vekkax/Braille_Display/Circuit_design/imports/Same_Sky_CMT-8503-90-SMT-TR/BOM.txt

3DX_Same_Sky_Supplier: Same Sky
3DX_Same_Sky_Description: 8.5 mm, 3.6 Vo-p, 90 dB, Surface Mount (SMT), Magnetic Audio Transducer Buzzer
3DX_Same_Sky_Model Number: CMT-8503-90-SMT-TR
