vekkax/Braille_Display/3d_models/Print_files/[24 piezas] cam.stl

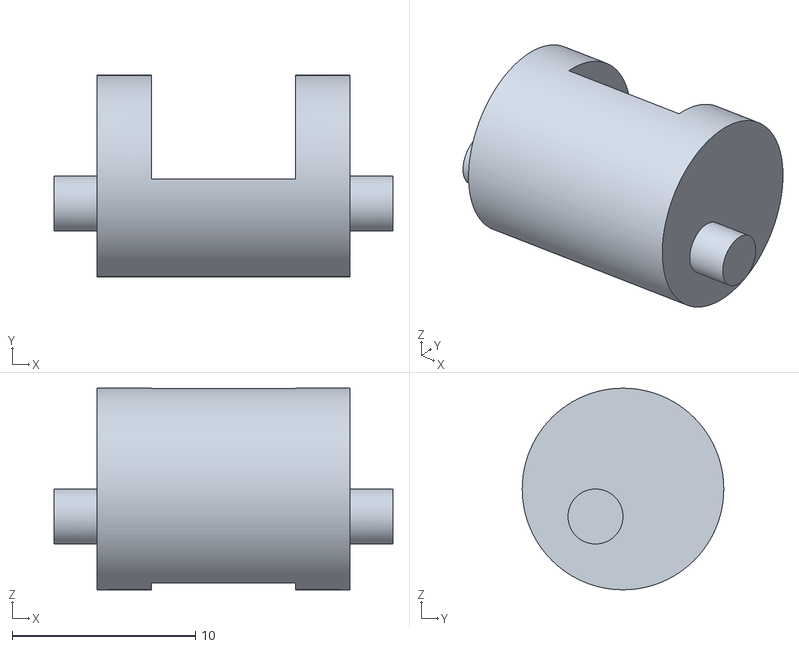
[picture p1: CAD file, 2025-09-04]
3d_models/Print_files/[24 piezas] cam.stl
18.5 x 11.0 x 11.0
