vekkax/Braille_Display/Circuit_design/cuts.dxf

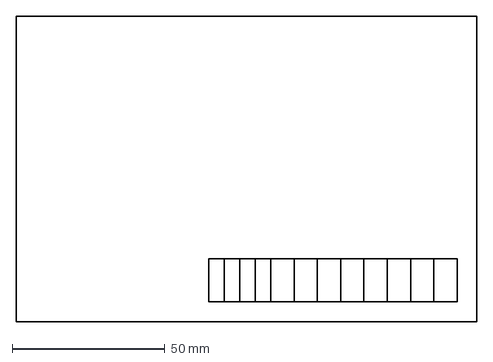
[picture p2: CAD file, 2025-09-04]
Circuit_design/cuts.dxf
150.5 x 100.0 mm
