vekkax/Braille_Display/Circuit_design/imports/AP7583AQ-33MP-13/3D/AP7583AQ-33MP-13.stp

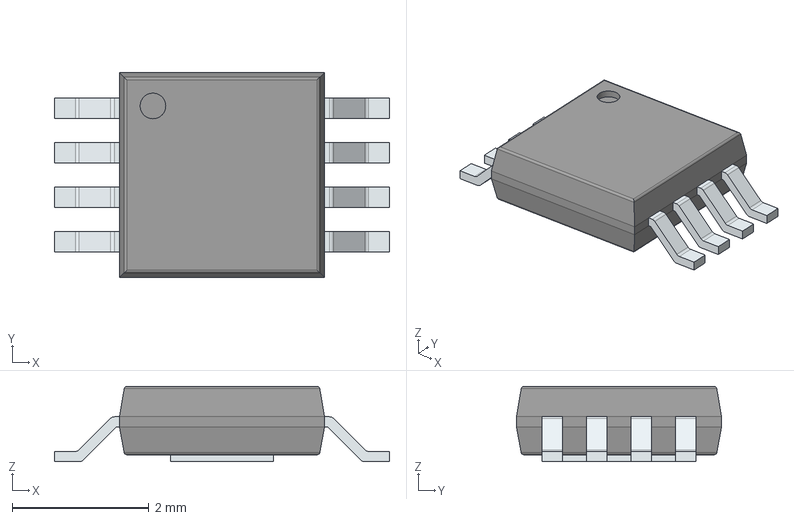
[picture p3: CAD file, 2025-09-04]
Circuit_design/imports/AP7583AQ-33MP-13/3D/AP7583AQ-33MP-13.stp
4.90 x 3.00 x 1.10 mm
PinsArrayLR
ThermalPad
