vekkax/Braille_Display/Circuit_design/imports/CMT-0525-75-SMT-TR/CMT-0525-75-SMT-TR.step

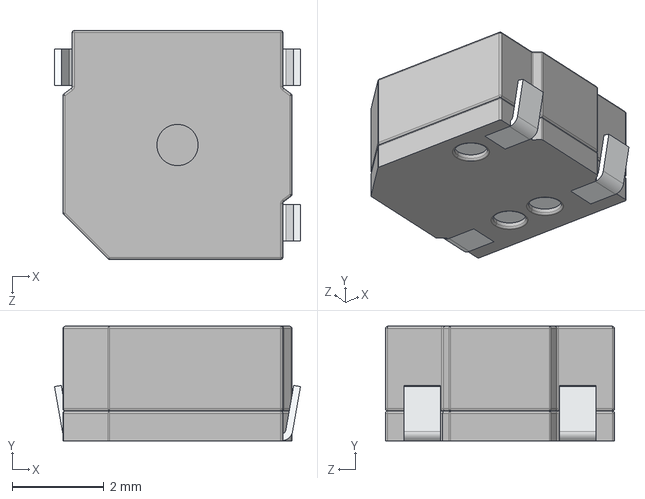
[picture p4: CAD file, 2025-09-04]
Circuit_design/imports/CMT-0525-75-SMT-TR/CMT-0525-75-SMT-TR.step
5.37 x 2.50 x 5.00 mm
