vekkax/Braille_Display/Circuit_design/imports/CMT-8503-90-SMT-TR/CMT-8503-90-SMT-TR.step

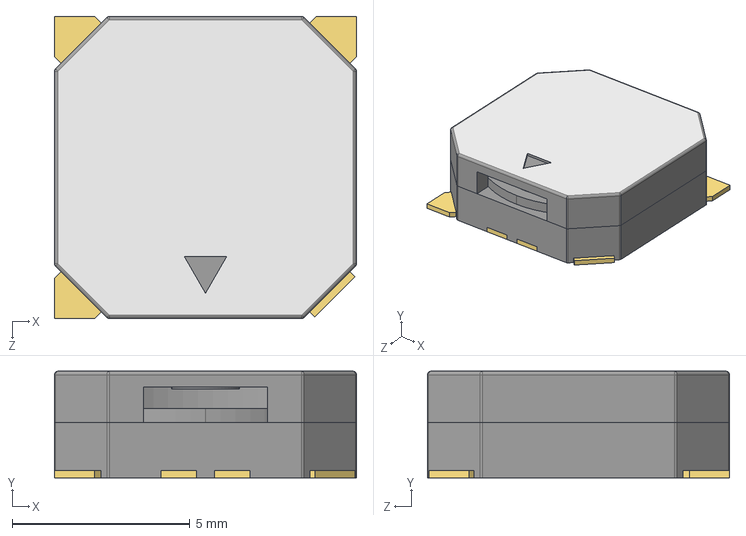
[picture p5: CAD file, 2025-09-04]
Circuit_design/imports/CMT-8503-90-SMT-TR/CMT-8503-90-SMT-TR.step
8.50 x 3.00 x 8.50 mm
