vekkax/Braille_Display/Circuit_design/imports/IHLP2525CZER4R7MA1/IHLP2525CZ.step

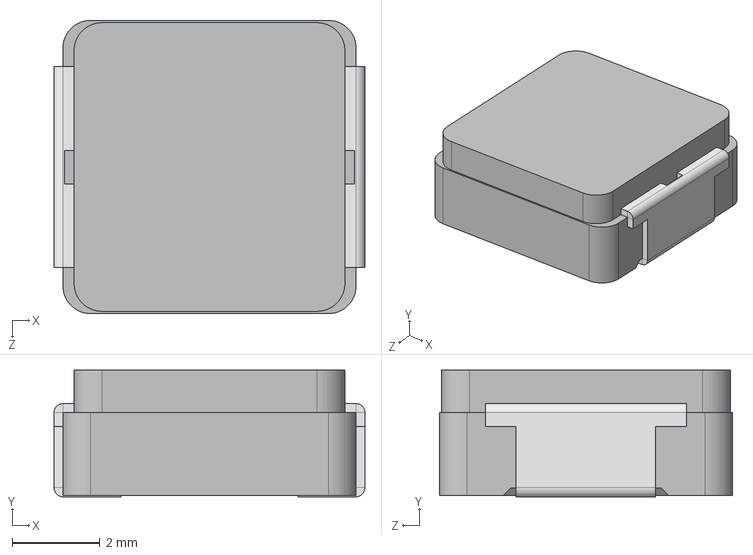
[picture p6: CAD file, 2025-09-04]
Circuit_design/imports/IHLP2525CZER4R7MA1/IHLP2525CZ.step
7.08 x 2.88 x 6.67 mm
