vekkax/Braille_Display/Circuit_design/imports/STM32F031G4U6.step

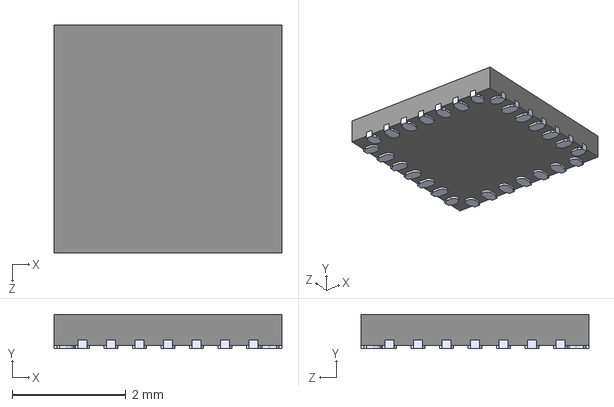
[picture p7: CAD file, 2025-09-04]
Circuit_design/imports/STM32F031G4U6.step
4.00 x 0.6 x 4.00 mm
