vekkax/Braille_Display/Circuit_design/Panelization/Top_layer.step

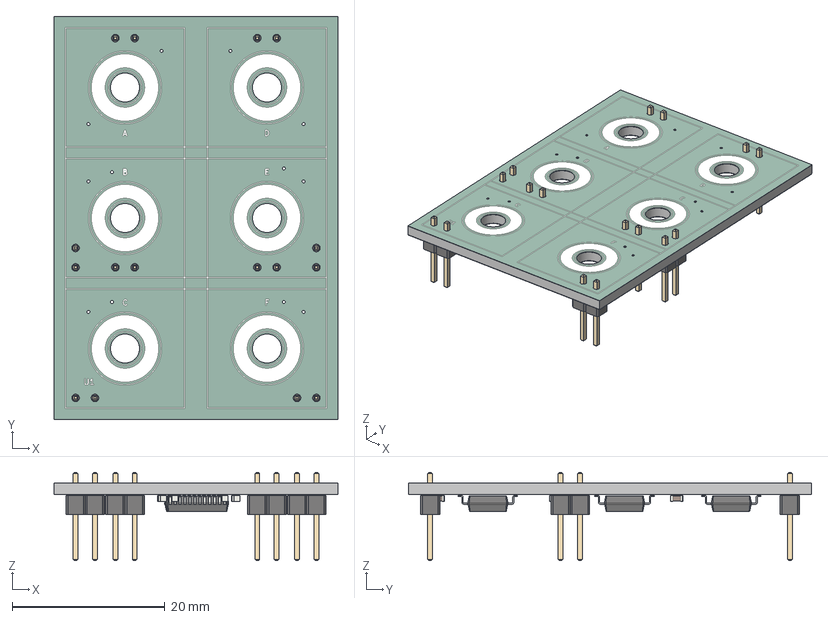
[picture p8: CAD file, 2025-09-04]
Circuit_design/Panelization/Top_layer.step
37.2 x 52.8 x 11.5 mm
PinHeader_1x02_P2.54mm_Vertical x 8
C_0603_1608Metric x 12
SSOP-24_5.3x8.2mm_P0.65mm x 3
Top_layer_silkscreen
Top_layer_soldermask
Top_layer_PCB
