vekkax/Braille_Display/3d_models/Print_files/[24 piezas] dot.stl

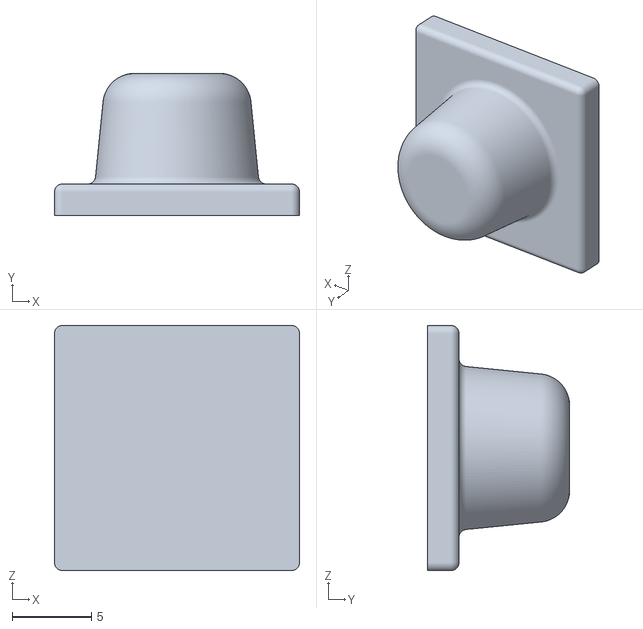
[picture p9: CAD file, 2025-09-04]
3d_models/Print_files/[24 piezas] dot.stl
15.5 x 9.00 x 15.5
