vekkax/Braille_Display/Circuit_design/imports/QFN18_2mmx3mm_model.step

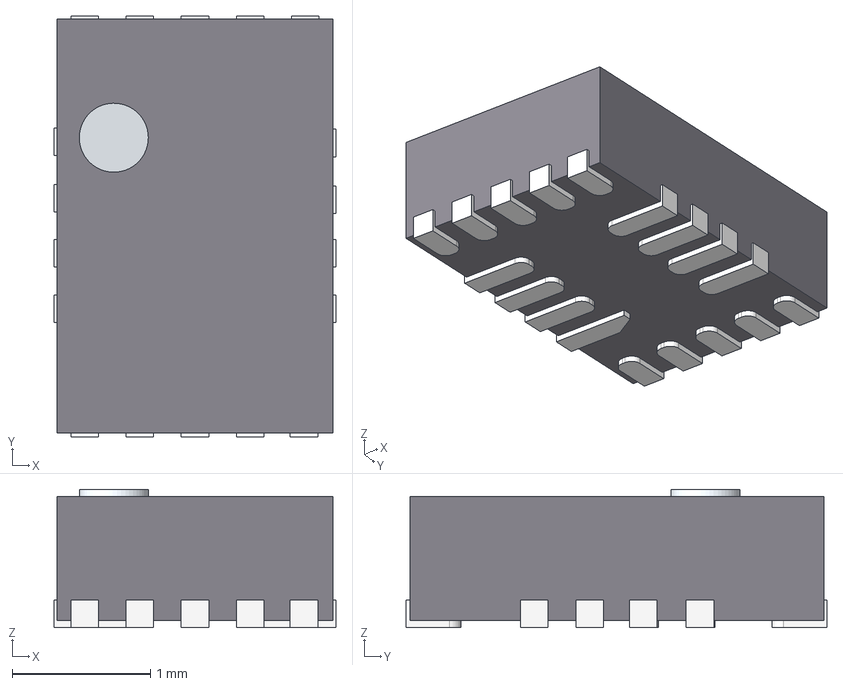
[picture p10: CAD file, 2025-09-04]
Circuit_design/imports/QFN18_2mmx3mm_model.step
2.04 x 3.05 x 1.00 mm
Pin1-IndexPad
Pin2-LongPad
Pin3-LongPad
Pin4-LongPad
Pin5-ShortPad
Pin6-ShortPad
Pin7-ShortPad
Pin8-ShortPad
Pin9-ShortPad
Pin10-LongPad
Pin11-LongPad
Pin12-LongPad
Pin13-LongPad
Pin14-ShortPad
Pin15-ShortPad
Pin16-ShortPad
Pin17-ShortPad
Pin18-ShortPad
CopyPart__Feature
