vekkax/Braille_Display/Circuit_design/imports/STM32L031F6P6.step

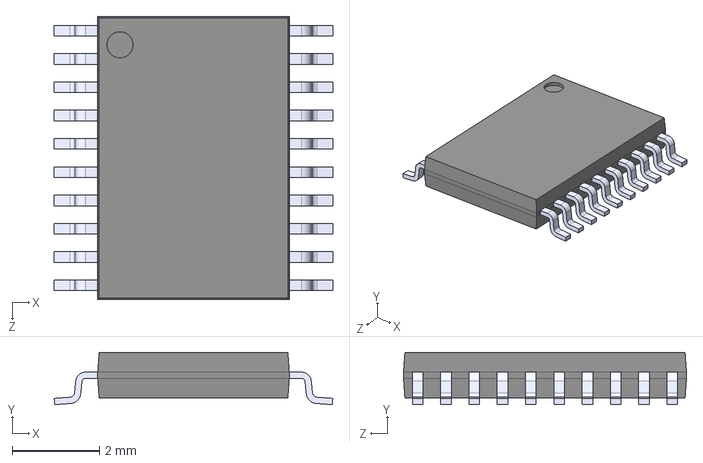
[picture p12: CAD file, 2025-09-04]
Circuit_design/imports/STM32L031F6P6.step
6.40 x 1.20 x 6.50 mm
