vekkax/Braille_Display/3d_models/Print_files/[4 piezas] inner_top.stl

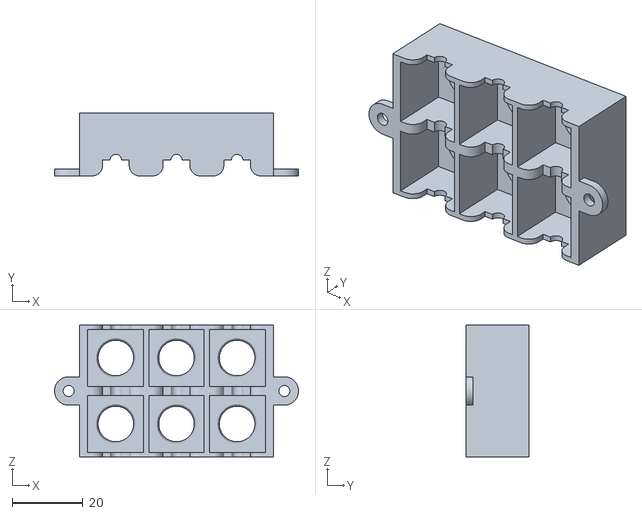
[picture p13: CAD file, 2025-09-04]
3d_models/Print_files/[4 piezas] inner_top.stl
68.8 x 17.8 x 37.2
