vekkax/Braille_Display/Circuit_design/imports/TB6612FNG.step

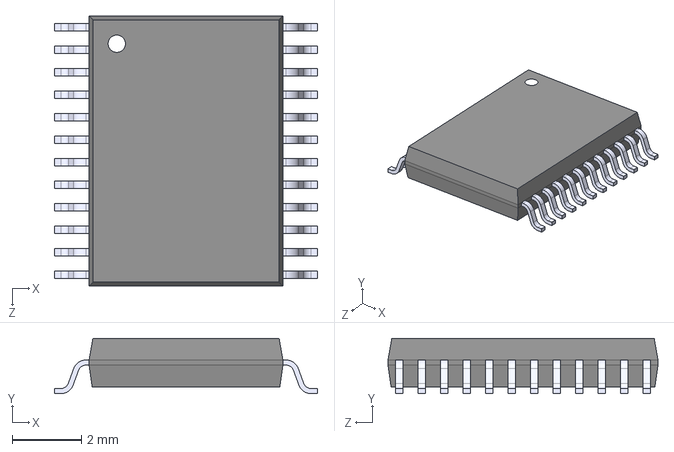
[picture p14: CAD file, 2025-09-04]
Circuit_design/imports/TB6612FNG.step
7.60 x 1.60 x 7.80 mm
