vekkax/Braille_Display/3d_models/Print_files/[4 piezas] inner_conn.stl

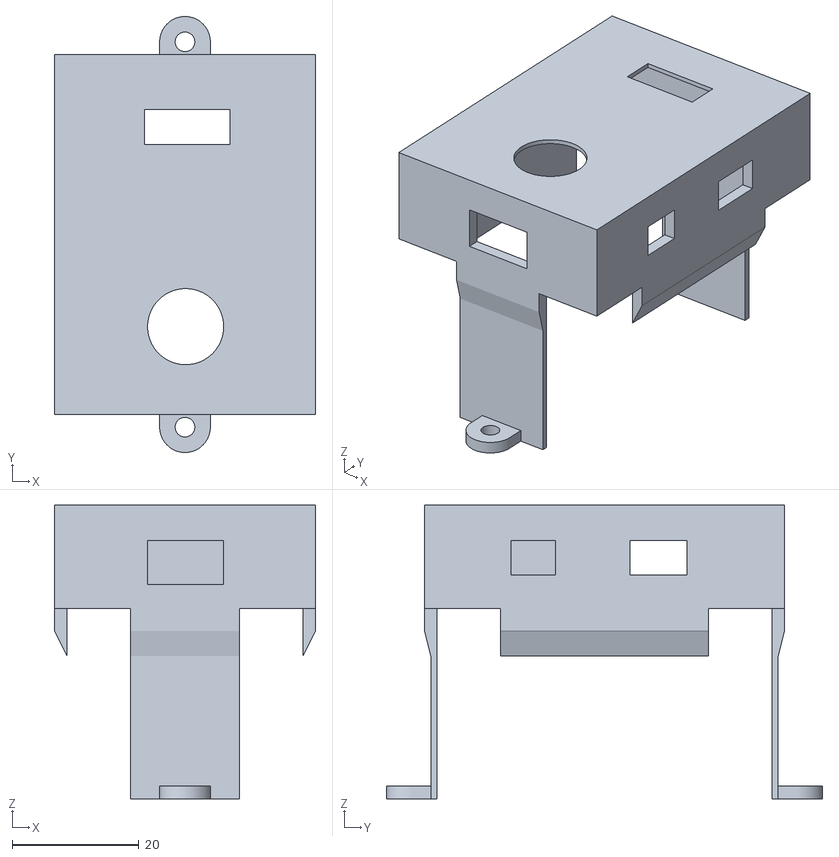
[picture p15: CAD file, 2025-09-04]
3d_models/Print_files/[4 piezas] inner_conn.stl
41.2 x 68.8 x 46.3
