vekkax/Braille_Display/3d_models/Print_files/[4 piezas] shell_top.stl

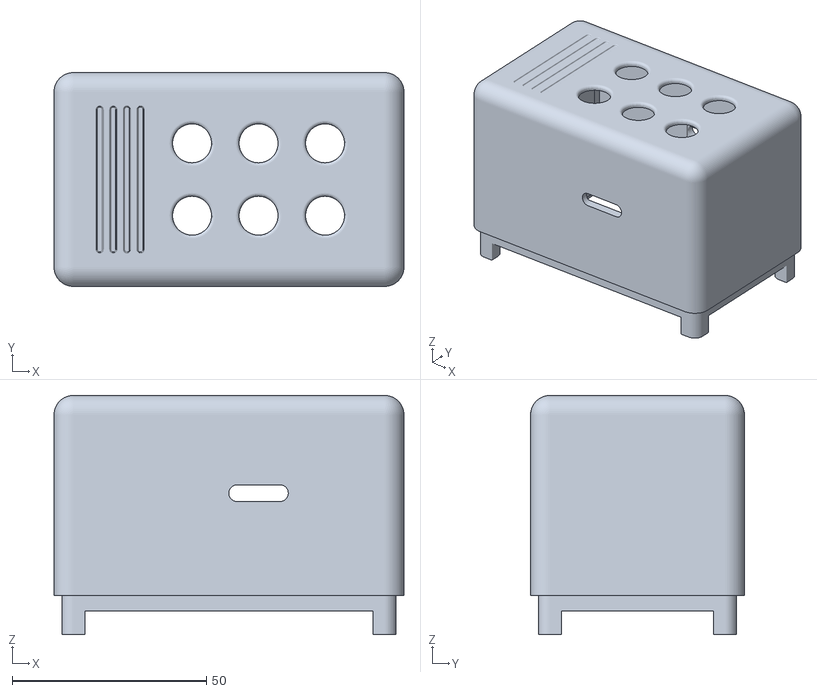
[picture p16: CAD file, 2025-09-04]
3d_models/Print_files/[4 piezas] shell_top.stl
90.0 x 55.0 x 61.5
