vekkax/Braille_Display/3d_models/Print_files/[4 piezas] inner_bttm.stl

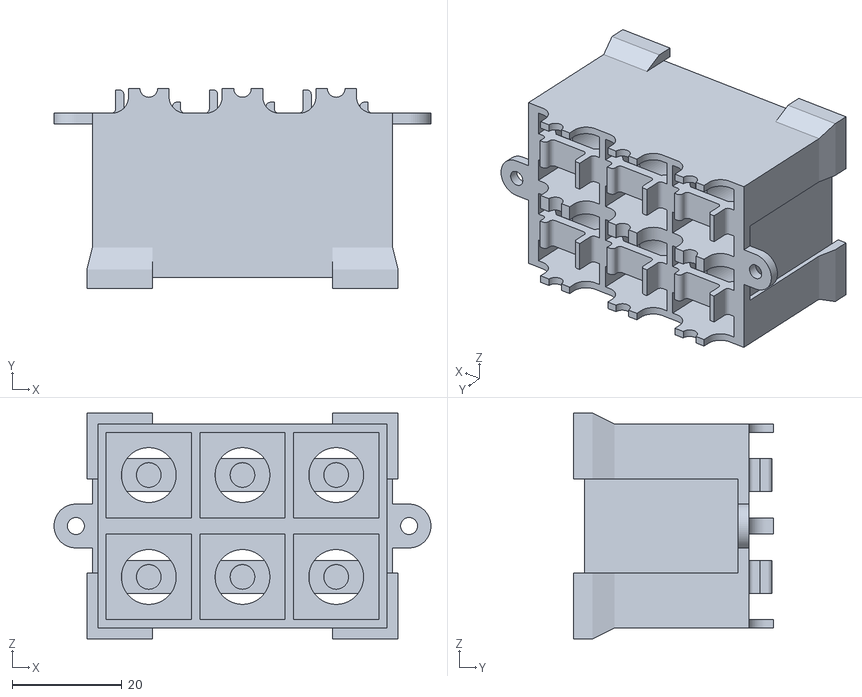
[picture p17: CAD file, 2025-09-04]
3d_models/Print_files/[4 piezas] inner_bttm.stl
68.8 x 36.5 x 41.2
