vekkax/Braille_Display/(list of files, cad)

Other CAD files:
Circuit_design/imports/Same_Sky_CMT-8503-90-SMT-TR/Same_Sky_CMT-8503-90-SMT-TR.step
Circuit_design/Circuit_design-B_Paste.dxf
Circuit_design/Panelization/Bottom_layer-F_Mask.dxf
Circuit_design/Panelization/Bottom_layer-F_Paste.dxf
Circuit_design/Panelization/Bottom_layer/Bottom_layer/AP7583AQ-33MP-13.iam
Circuit_design/Panelization/Bottom_layer/Bottom_layer/Body.ipt
Circuit_design/Panelization/Bottom_layer/Bottom_layer/Body_1.ipt
Circuit_design/Panelization/Bottom_layer/Bottom_layer/Bottom_layer.iam
Circuit_design/Panelization/Bottom_layer/Bottom_layer/Bottom_layer_PCB.ipt
Circuit_design/Panelization/Bottom_layer/Bottom_layer/Bottom_layer_silkscreen.ipt
Circuit_design/Panelization/Bottom_layer/Bottom_layer/Bottom_layer_soldermask.ipt
Circuit_design/Panelization/Bottom_layer/Bottom_layer/Box.ipt
Circuit_design/Panelization/Bottom_layer/Bottom_layer/C_0603_1608Metric.ipt
Circuit_design/Panelization/Bottom_layer/Bottom_layer/C_0805_2012Metric.ipt
Circuit_design/Panelization/Bottom_layer/Bottom_layer/CopyPart__Feature.ipt
Circuit_design/Panelization/Bottom_layer/Bottom_layer/D_SOD-923.ipt
Circuit_design/Panelization/Bottom_layer/Bottom_layer/IHLP2525CZ.ipt
Circuit_design/Panelization/Bottom_layer/Bottom_layer/JST_PH_S2B-PH-K_1x02_P2.00mm_Horizontal.ipt
Circuit_design/Panelization/Bottom_layer/Bottom_layer/JST_PH_S3B-PH-K_1x03_P2.00mm_Horizontal.ipt
Circuit_design/Panelization/Bottom_layer/Bottom_layer/Pad.ipt
Circuit_design/Panelization/Bottom_layer/Bottom_layer/Pin1-IndexPad.ipt
Circuit_design/Panelization/Bottom_layer/Bottom_layer/Pin10-LongPad.ipt
Circuit_design/Panelization/Bottom_layer/Bottom_layer/Pin11-LongPad.ipt
Circuit_design/Panelization/Bottom_layer/Bottom_layer/Pin12-LongPad.ipt
Circuit_design/Panelization/Bottom_layer/Bottom_layer/Pin13-LongPad.ipt
Circuit_design/Panelization/Bottom_layer/Bottom_layer/Pin14-ShortPad.ipt
Circuit_design/Panelization/Bottom_layer/Bottom_layer/Pin15-ShortPad.ipt
Circuit_design/Panelization/Bottom_layer/Bottom_layer/Pin16-ShortPad.ipt
Circuit_design/Panelization/Bottom_layer/Bottom_layer/Pin17-ShortPad.ipt
Circuit_design/Panelization/Bottom_layer/Bottom_layer/Pin18-ShortPad.ipt
Circuit_design/Panelization/Bottom_layer/Bottom_layer/Pin2-LongPad.ipt
Circuit_design/Panelization/Bottom_layer/Bottom_layer/Pin3-LongPad.ipt
Circuit_design/Panelization/Bottom_layer/Bottom_layer/Pin4-LongPad.ipt
Circuit_design/Panelization/Bottom_layer/Bottom_layer/Pin5-ShortPad.ipt
Circuit_design/Panelization/Bottom_layer/Bottom_layer/Pin6-ShortPad.ipt
Circuit_design/Panelization/Bottom_layer/Bottom_layer/Pin7-ShortPad.ipt
Circuit_design/Panelization/Bottom_layer/Bottom_layer/Pin8-ShortPad.ipt
Circuit_design/Panelization/Bottom_layer/Bottom_layer/Pin9-ShortPad.ipt
Circuit_design/Panelization/Bottom_layer/Bottom_layer/PinHeader_2x05_P1.27mm_Vertical.ipt
Circuit_design/Panelization/Bottom_layer/Bottom_layer/PinSocket_1x02_P2.54mm_Vertical.ipt
Circuit_design/Panelization/Bottom_layer/Bottom_layer/PinsArrayLR.ipt
Circuit_design/Panelization/Bottom_layer/Bottom_layer/QFN18_2mmx3mm_model.iam
Circuit_design/Panelization/Bottom_layer/Bottom_layer/R_0805_2012Metric.ipt
Circuit_design/Panelization/Bottom_layer/Bottom_layer/STM32F031G4U6.ipt
Circuit_design/Panelization/Bottom_layer/Bottom_layer/ThermalPad.ipt
Circuit_design/Panelization/Top_layer/Top_layer/C_0603_1608Metric.ipt
Circuit_design/Panelization/Top_layer/Top_layer/PinHeader_1x02_P2.54mm_Vertical.ipt
Circuit_design/Panelization/Top_layer/Top_layer/SSOP-24_5.3x8.2mm_P0.65mm.ipt
Circuit_design/Panelization/Top_layer/Top_layer/Top_layer.iam
Circuit_design/Panelization/Top_layer/Top_layer/Top_layer_PCB.ipt
Circuit_design/Panelization/Top_layer/Top_layer/Top_layer_silkscreen.ipt
Circuit_design/Panelization/Top_layer/Top_layer/Top_layer_soldermask.ipt
Circuit_design/conector cuts.ipt
