vekkax/Braille_Display/Circuit_design/imports/EB_manual_en_20180921/GerberList.xls

GERBER LIST
■General information
Garber format |  | RS-274X
CAD |  | PADS
Layer |  | 4L
size |  | X: 180mm Y: 80mm
■Drill Data
 | Details | File name
1 | Drill data | DRILL
2 | Drill List | DRILL.TXT
■Gerber list
 | Details | File name
1 | 部品面パターン（Component side Pattern） | GTL
2 | 半田面パターン（Solder side Pattern） | GBL
3 | 部品面レジスト（Component side Resist） | GTS
4 | 半田面レジスト（Solder side Resist） | GBS
5 | 部品面シルク（Component side Silk） | GTO
6 | 半田面シルク（Solder side Silk） | -
7 | 外形（Board data） | OUTLINE
8 | 2層目のパターン（Ｌ2Pattern） | L2
9 | 3層目のパターン（Ｌ3Pattern） | L3
10 | 外形寸法図(Outline drawing) | sunpou.pdf
11 | 穴図（キリ穴有る場合に必要）(Hole drawing) | NTH drill drawing.pdf
12 | 部品面メタルマスク（Component side Paste） | GTP
13 | 半田面メタルマスク（Solder side Paste） | -
14 | 部品座標(Component coordinate data) | PARTS_xy.xls
15 | Vcut | -
16
17
18
19
20
Note: | 外形図以外のパターン図に外形レイヤーを含まない
 |  | 絶対座標(Absolute)
 |  | 相対座標(Increment)
 |  | ミリ(mm)
 |  | インチ(Inch)
 |  | リーディング(Leading)
 |  | トレイリング(Trailing)
 |  | サプレス無し(None)
 | 外形図に寸法・穴を記載しない
 | 内層反転の場合、外形よけベタ輪郭必要
■NC output option
座標系 | 絶対座標／相対座標 | 絶対座標(Absolute)
Coordinates | Absolute/Increment
単位 | ミリ／インチ | ミリ(mm)
Units | mm/Inch
ゼロ・サプレス | リーディング（先行）/トレイリング（後方）/無し | リーディング(Leading)
Zero supless | leading／trailing／none
小数点 | 整数部桁数：小数部桁数 (例）3 : 2 | 3:3
Digits | Integer : Decimal (ex.) 3 : 2
Note: | ＮＣ原点はガーバー原点と合致させる
 | インチ・ミリ系が混在していないこと
■Gerber output option (RS-274D only)
座標系 | 絶対座標／相対座標
Coordinates | Absolute/Increment
単位 | ミリ／インチ
Units | mm/Inch
ゼロ・サプレス | リーディング（先行）/トレイリング（後方）/無し
Zero supless | leading／trailing／none
小数点 | 整数部桁数：小数部桁数 (例）3 : 2
Digits | Integer : Decimal (ex.) 3 : 2
