vekkax/Braille_Display/Circuit_design/imports/EB_manual_en_20180921/drill drawing.pdf

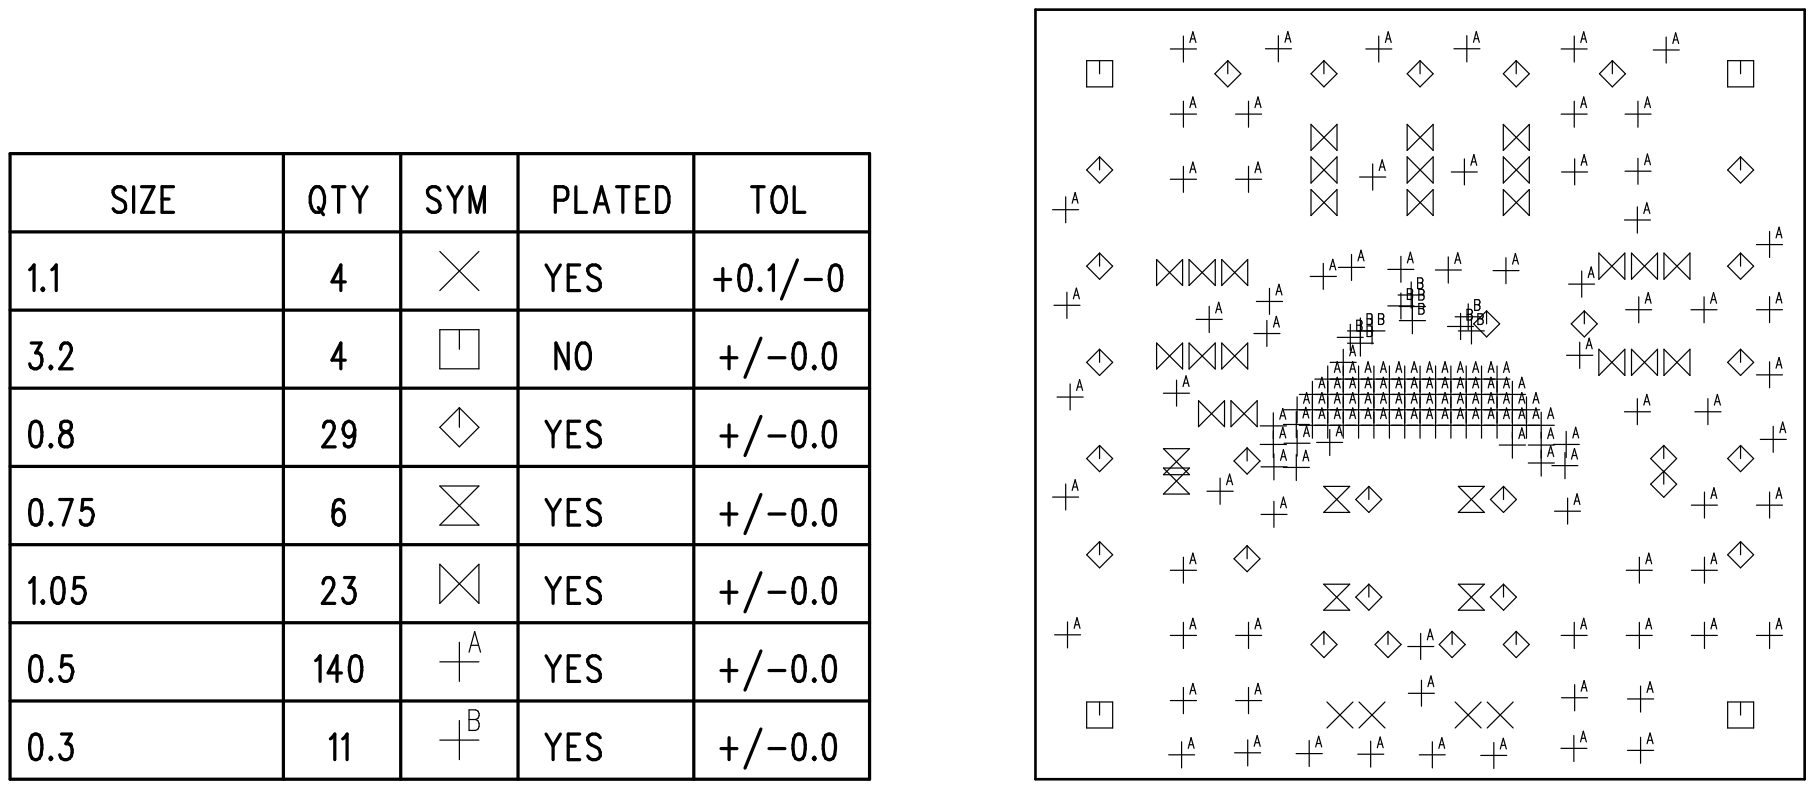
[picture p18: page 1]
