vekkax/Braille_Display/Circuit_design/imports/EB_manual_en_20180921/NTH drill drawing.pdf

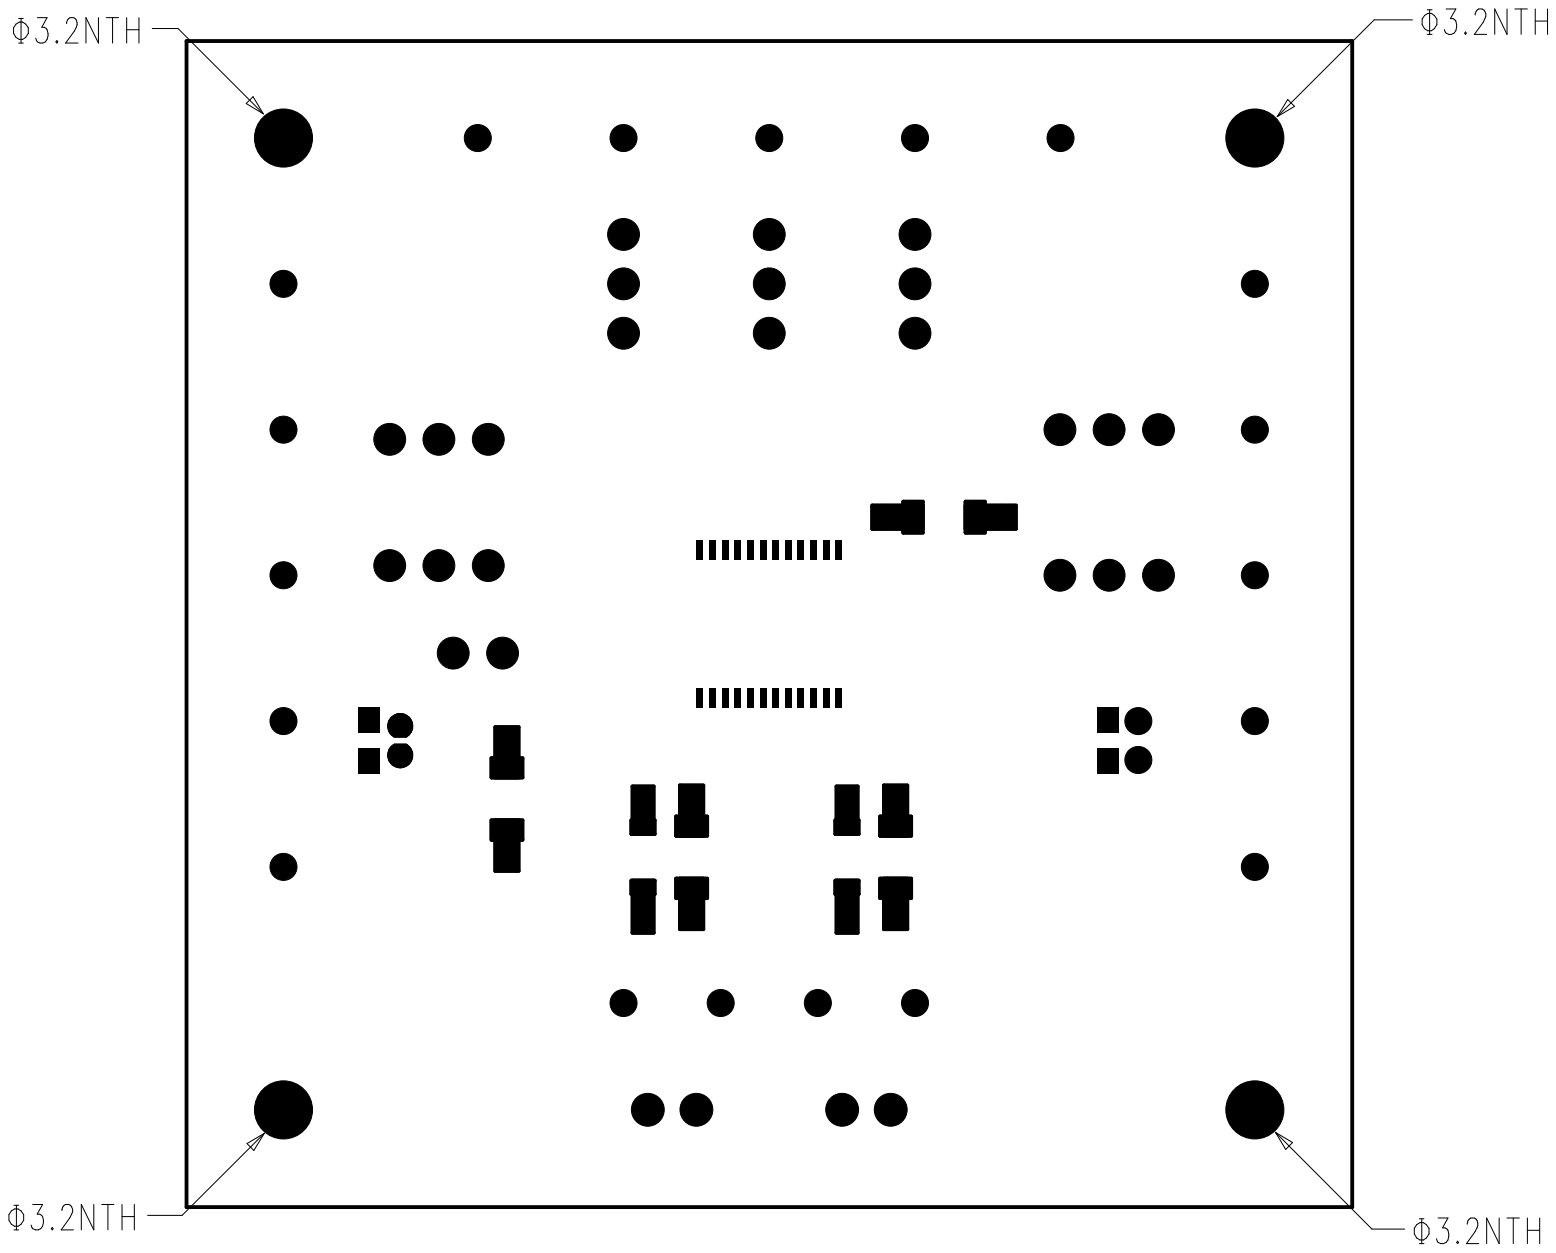
[picture p19: page 1]
