vekkax/Braille_Display/Circuit_design/imports/EB_manual_en_20180921/sunpou.pdf

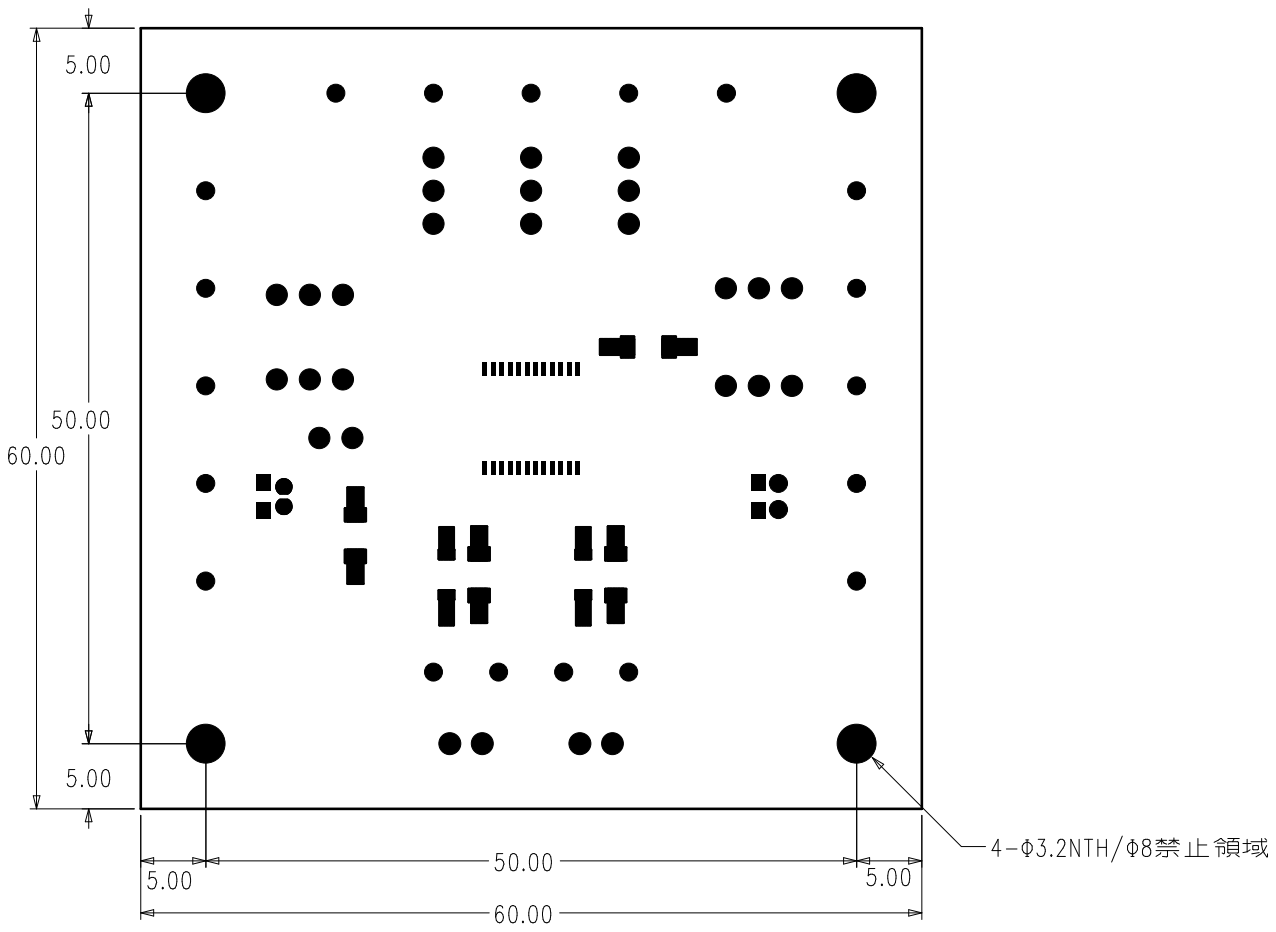
[picture p20: page 1]
