vekkax/Braille_Display/Circuit_design/Circuit_design.kicad_pcb

## KiCad design Circuit_design/Circuit_design.kicad_pcb (2025-09-04)

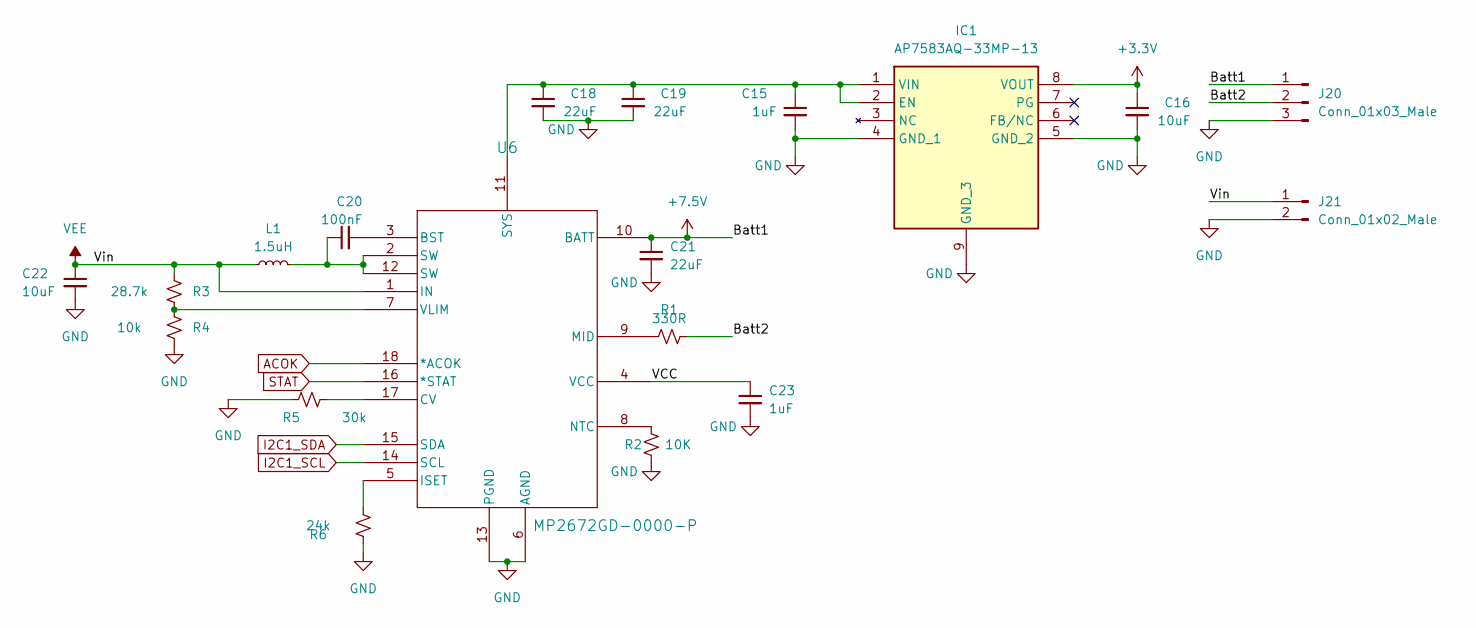
[picture p21: schematic Power_suply.kicad_sch]

Parts:
C15, C23: 1uF; C_0805_2012Metric_Pad1.18x1.45mm_HandSolder
C16, C22: 10uF; C_0805_2012Metric_Pad1.18x1.45mm_HandSolder
C18, C19, C21: 22uF; C_0805_2012Metric_Pad1.18x1.45mm_HandSolder
C20: 100nF; C_0805_2012Metric_Pad1.18x1.45mm_HandSolder
IC1: AP7583AQ-33MP-13; SOP65P490X110-9N; Mouser Part Number 621-AP7583AQ-33MP-13
J20: Conn_01x03_Male; JST_PH_S3B-PH-K_1x03_P2.00mm_Horizontal
J21: Conn_01x02_Male; JST_PH_S2B-PH-K_1x02_P2.00mm_Horizontal
L1: 1.5uH; L_Vishay_IHLP-2525
R1: 330R; R_0805_2012Metric_Pad1.20x1.40mm_HandSolder
R2: 10K; R_0805_2012Metric_Pad1.20x1.40mm_HandSolder
R3: 28.7k; R_0805_2012Metric_Pad1.20x1.40mm_HandSolder
R4: 10k; R_0805_2012Metric_Pad1.20x1.40mm_HandSolder
R5: 30k; R_0805_2012Metric_Pad1.20x1.40mm_HandSolder
R6: 24k; R_0805_2012Metric_Pad1.20x1.40mm_HandSolder
U6: MP2672GD-0000-P; QFN-18_2MMx3MM_MP2672_MNP_MPS

Connections:
+3.3V: C16.1, IC1.8 (VOUT); also elsewhere on the board
+7.5V: C21.1, J20.1, U6.10 (BATT); also elsewhere on the board
/Power_suply/Batt2: J20.2, R1.2
/Power_suply/VCC: C23.1, U6.4 (VCC)
ACOK: U6.18 (*ACOK)
GND: C15.2, C16.2, C18.2, C19.2, C21.2, C22.2, C23.2, IC1.4 (GND_1), IC1.5 (GND_2), IC1.9 (GND_3), J20.3, J21.2, R2.2, R4.1, R5.1, R6.1, U6.6 (AGND), U6.13 (PGND); also elsewhere on the board
I2C1_SCL: U6.14 (SCL); also elsewhere on the board
I2C1_SDA: U6.15 (SDA); also elsewhere on the board
unnamed: C20.1, L1.2, U6.2 (SW), U6.12 (SW)
unnamed: C15.1, C18.1, C19.1, IC1.1 (VIN), IC1.2 (EN), U6.11 (SYS)
unnamed: C20.2, U6.3 (BST)
unnamed: R5.2, U6.17 (CV)
unnamed: R6.2, U6.5 (ISET)
unnamed: R1.1, U6.9 (MID)
unnamed: R2.1, U6.8 (NTC)
unnamed: R3.1, R4.2, U6.7 (VLIM)
STAT: U6.16 (*STAT)
VEE: C22.1, J21.1, L1.1, R3.2, U6.1 (IN)

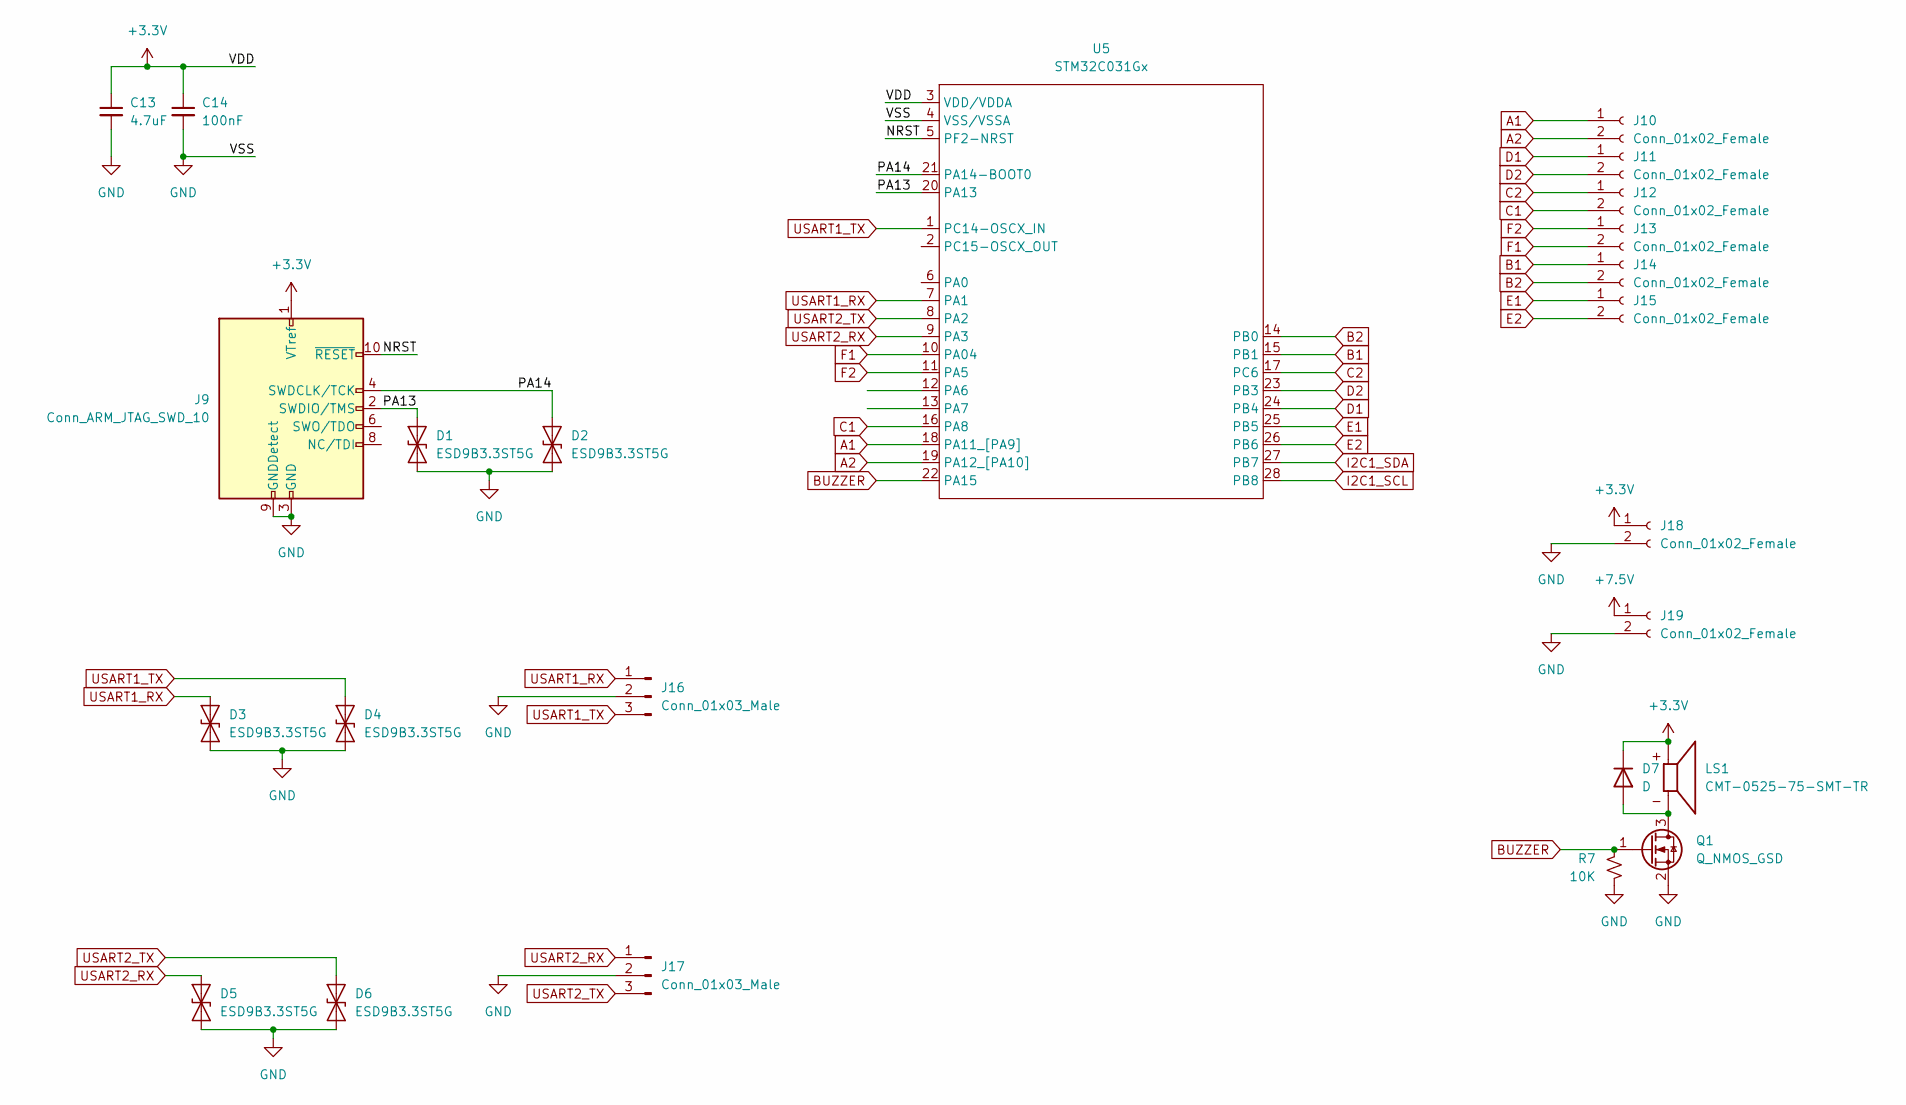
[picture p22: schematic MCU.kicad_sch]

Parts:
C13: 4.7uF; C_0603_1608Metric_Pad1.08x0.95mm_HandSolder
C14: 100nF; C_0603_1608Metric_Pad1.08x0.95mm_HandSolder
D1, D2, D3, D4, D5, D6: ESD9B3.3ST5G; D_SOD-923
D7: D; D_SOD-323
J9: Conn_ARM_JTAG_SWD_10; PinHeader_2x05_P1.27mm_Vertical
J10, J11, J12, J13, J14, J15, J18, J19: Conn_01x02_Female; PinSocket_1x02_P2.54mm_Vertical
J16, J17: Conn_01x03_Male; JST_PH_S3B-PH-K_1x03_P2.00mm_Horizontal
LS1: CMT-0525-75-SMT-TR; XDCR_CMT-0525-75-SMT-TR; PARTREV 1.0
Q1: Q_NMOS_GSD; SOT-23-3
R7: 10K; R_0805_2012Metric_Pad1.20x1.40mm_HandSolder
U5: STM32C031Gx; QFN50P400X400X60-28N

Connections:
+3.3V: C13.1, C14.1, D7.1 (K), J9.1 (VTref), J18.1, LS1.P, U5.3 (VDD/VDDA); also elsewhere on the board
+7.5V: J19.1; also elsewhere on the board
/MCU/NRST: J9.10 (~RESET), U5.5 (PF2-NRST)
/MCU/PA13: D1.2 (A2), J9.2 (SWDIO/TMS), U5.20 (PA13)
/MCU/PA14: D2.2 (A2), J9.4 (SWDCLK/TCK), U5.21 (PA14-BOOT0)
A1: J10.1, U5.18 (PA11_[PA9]); also elsewhere on the board
A2: J10.2, U5.19 (PA12_[PA10]); also elsewhere on the board
B1: J14.1, U5.15 (PB1); also elsewhere on the board
B2: J14.2, U5.14 (PB0); also elsewhere on the board
BUZZER: Q1.1 (G), R7.1, U5.22 (PA15)
C1: J12.2, U5.16 (PA8); also elsewhere on the board
C2: J12.1, U5.17 (PC6); also elsewhere on the board
D1: J11.1, U5.24 (PB4); also elsewhere on the board
D2: J11.2, U5.23 (PB3); also elsewhere on the board
E1: J15.1, U5.25 (PB5); also elsewhere on the board
E2: J15.2, U5.26 (PB6); also elsewhere on the board
F1: J13.2, U5.10 (PA04); also elsewhere on the board
F2: J13.1, U5.11 (PA5); also elsewhere on the board
GND: C13.2, C14.2, D1.1 (A1), D2.1 (A1), D3.1 (A1), D4.1 (A1), D5.1 (A1), D6.1 (A1), J9.3 (GND), J9.5 (GND), J9.9 (GNDDetect), J16.2, J17.2, J18.2, J19.2, Q1.2 (S), R7.2, U5.4 (VSS/VSSA); also elsewhere on the board
I2C1_SCL: U5.28 (PB8); also elsewhere on the board
I2C1_SDA: U5.27 (PB7); also elsewhere on the board
unnamed: D7.2 (A), LS1.N, Q1.3 (D)
USART1_RX: D3.2 (A2), J16.1, U5.7 (PA1)
USART1_TX: D4.2 (A2), J16.3, U5.1 (PC14-OSCX_IN)
USART2_RX: D5.2 (A2), J17.1, U5.9 (PA3)
USART2_TX: D6.2 (A2), J17.3, U5.8 (PA2)

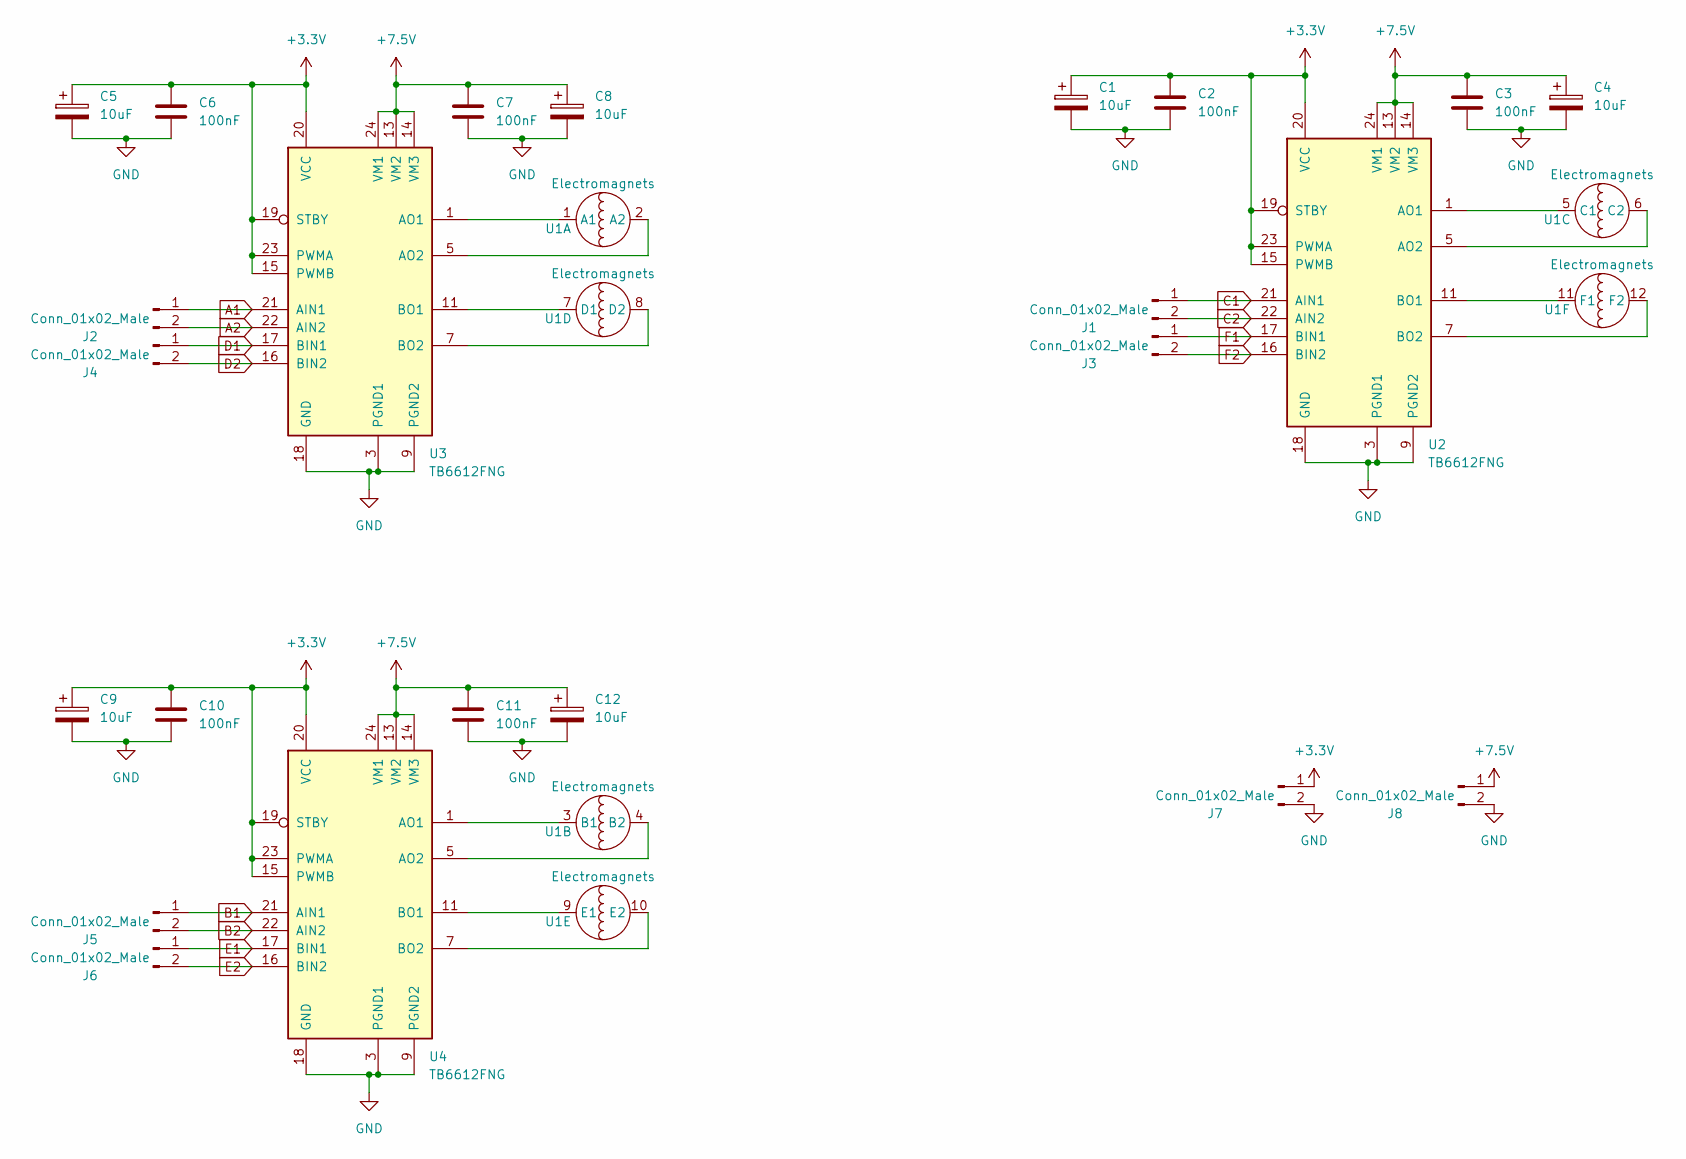
[picture p23: schematic Electromagnet_drive.kicad_sch]

Parts:
C1, C4, C5, C8, C9, C12: 10uF; C_0603_1608Metric_Pad1.08x0.95mm_HandSolder
C2, C3, C6, C7, C10, C11: 100nF; C_0603_1608Metric_Pad1.08x0.95mm_HandSolder
J1, J2, J3, J4, J5, J6, J7, J8: Conn_01x02_Male; PinHeader_1x02_P2.54mm_Vertical
U1: Electromagnets
U2, U3, U4: TB6612FNG; SSOP-24_5.3x8.2mm_P0.65mm

Connections:
+3.3V: C1.1, C2.1, C5.1, C6.1, C9.1, C10.1, J7.1, U2.15 (PWMB), U2.19 (STBY), U2.20 (VCC), U2.23 (PWMA), U3.15 (PWMB), U3.19 (STBY), U3.20 (VCC), U3.23 (PWMA), U4.15 (PWMB), U4.19 (STBY), U4.20 (VCC), U4.23 (PWMA); also elsewhere on the board
+7.5V: C3.1, C4.1, C7.1, C8.1, C11.1, C12.1, J8.1, U2.13 (VM2), U2.14 (VM3), U2.24 (VM1), U3.13 (VM2), U3.14 (VM3), U3.24 (VM1), U4.13 (VM2), U4.14 (VM3), U4.24 (VM1); also elsewhere on the board
A1: J2.1, U3.21 (AIN1); also elsewhere on the board
A2: J2.2, U3.22 (AIN2); also elsewhere on the board
B1: J5.1, U4.21 (AIN1); also elsewhere on the board
B2: J5.2, U4.22 (AIN2); also elsewhere on the board
C1: J1.1, U2.21 (AIN1); also elsewhere on the board
C2: J1.2, U2.22 (AIN2); also elsewhere on the board
D1: J4.1, U3.17 (BIN1); also elsewhere on the board
D2: J4.2, U3.16 (BIN2); also elsewhere on the board
E1: J6.1, U4.17 (BIN1); also elsewhere on the board
E2: J6.2, U4.16 (BIN2); also elsewhere on the board
F1: J3.1, U2.17 (BIN1); also elsewhere on the board
F2: J3.2, U2.16 (BIN2); also elsewhere on the board
GND: C1.2, C2.2, C3.2, C4.2, C5.2, C6.2, C7.2, C8.2, C9.2, C10.2, C11.2, C12.2, J7.2, J8.2, U2.3 (PGND1), U2.4 (PGND1), U2.9 (PGND2), U2.10 (PGND2), U2.18 (GND), U3.3 (PGND1), U3.4 (PGND1), U3.9 (PGND2), U3.10 (PGND2), U3.18 (GND), U4.3 (PGND1), U4.4 (PGND1), U4.9 (PGND2), U4.10 (PGND2), U4.18 (GND); also elsewhere on the board
unnamed: U1.1 (A1), U3.1 (AO1), U3.2 (AO1)
unnamed: U1.2 (A2), U3.5 (AO2), U3.6 (AO2)
unnamed: U1.3 (B1), U4.1 (AO1), U4.2 (AO1)
unnamed: U1.4 (B2), U4.5 (AO2), U4.6 (AO2)
unnamed: U1.5 (C1), U2.1 (AO1), U2.2 (AO1)
unnamed: U1.6 (C2), U2.5 (AO2), U2.6 (AO2)
unnamed: U1.7 (D1), U3.11 (BO1), U3.12 (BO1)
unnamed: U1.8 (D2), U3.7 (BO2), U3.8 (BO2)
unnamed: U1.9 (E1), U4.11 (BO1), U4.12 (BO1)
unnamed: U1.10 (E2), U4.7 (BO2), U4.8 (BO2)
unnamed: U1.11 (F1), U2.11 (BO1), U2.12 (BO1)
unnamed: U1.12 (F2), U2.7 (BO2), U2.8 (BO2)

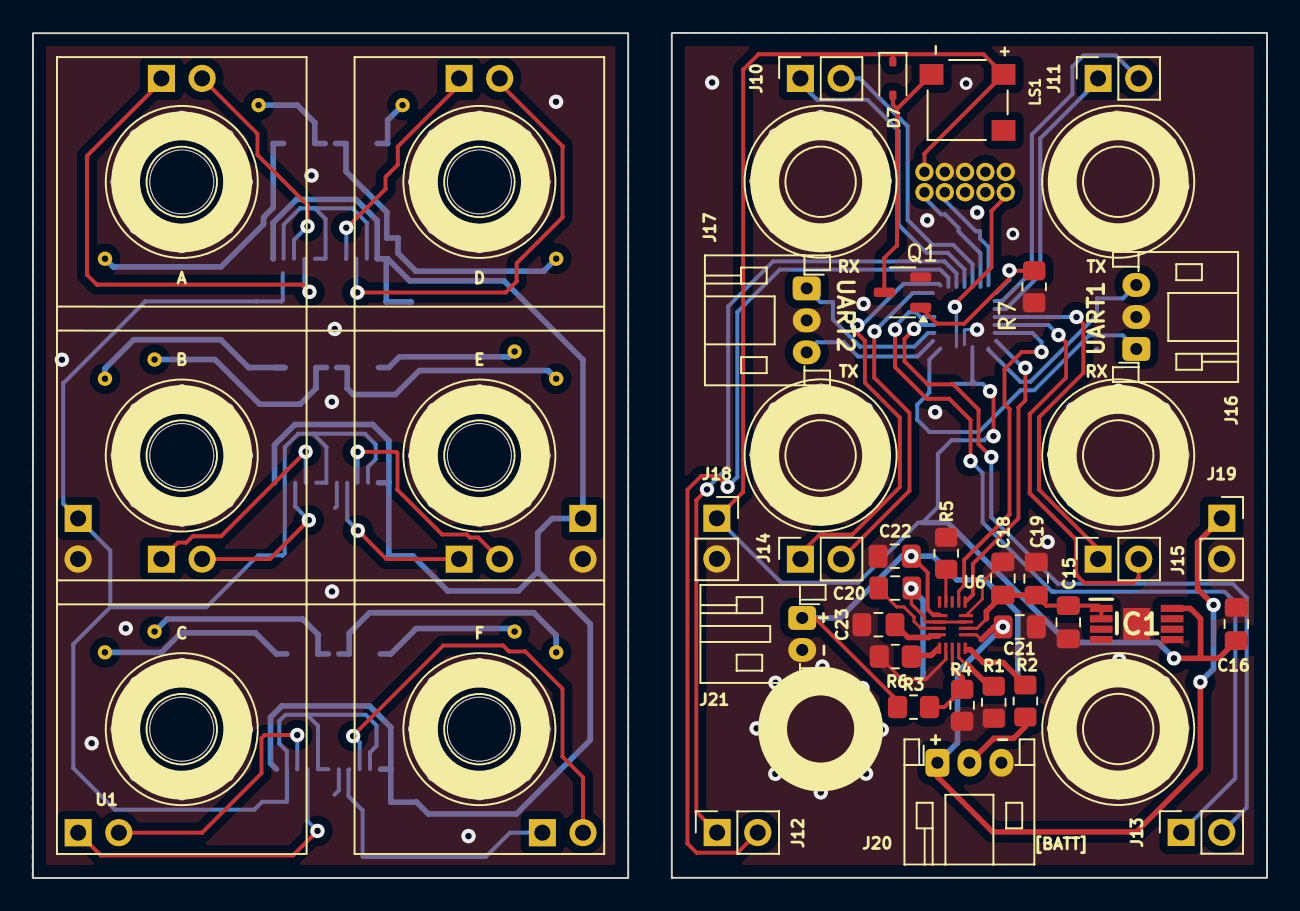
[picture p24: board Circuit_design.kicad_pcb from above]

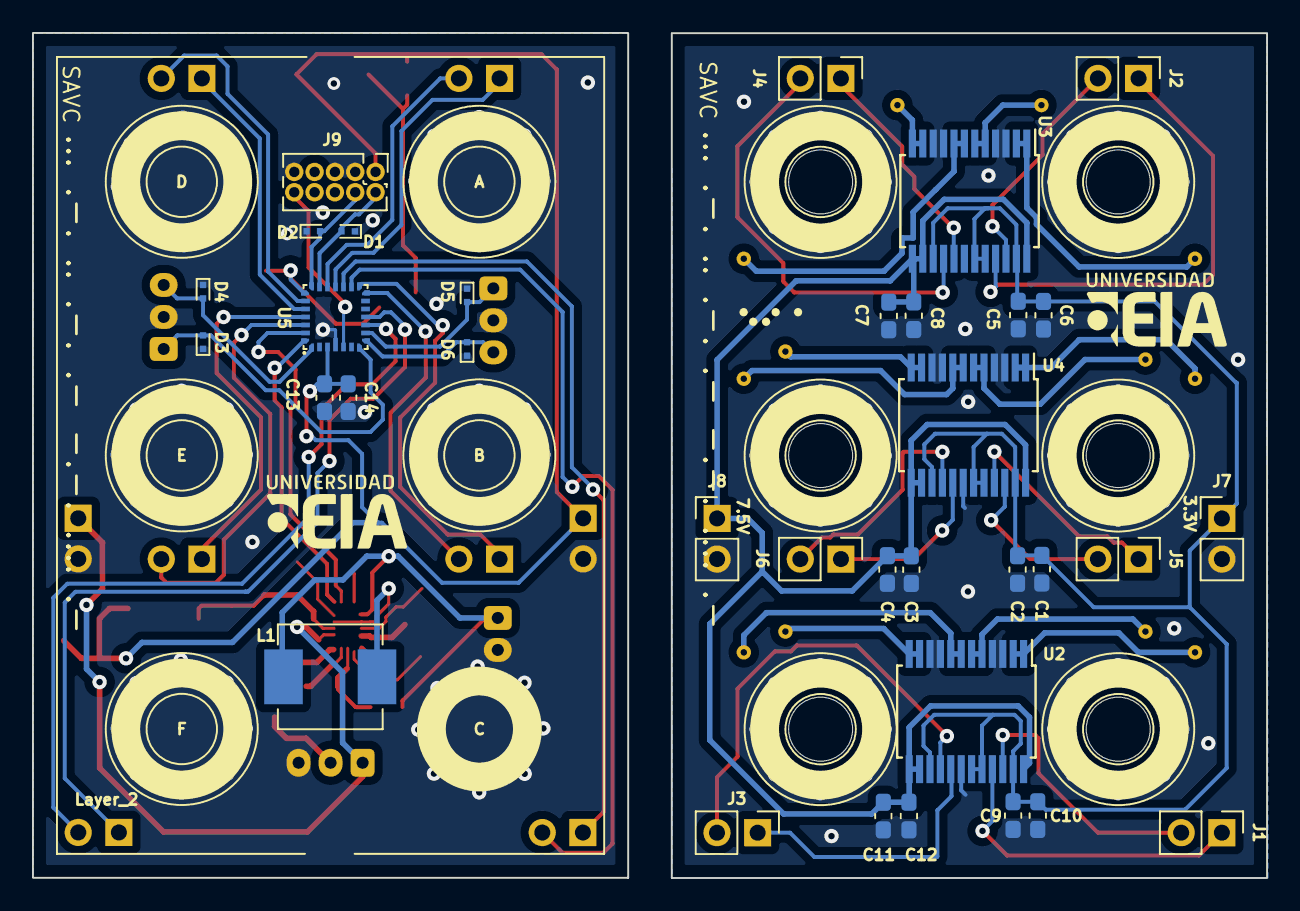
[picture p25: board Circuit_design.kicad_pcb from below]

Board: 2 copper layers, 77.1 x 52.8 mm, 68 parts (35 on the bottom side), 49 nets.

Other parts of the board:
Layer_2: Electromagnets_Layer_2
