vekkax/Braille_Display/Circuit_design/Panelization/Top_layer_Panel.kicad_pcb

## KiCad design Circuit_design/Panelization/Top_layer_Panel.kicad_pcb (2025-09-04)

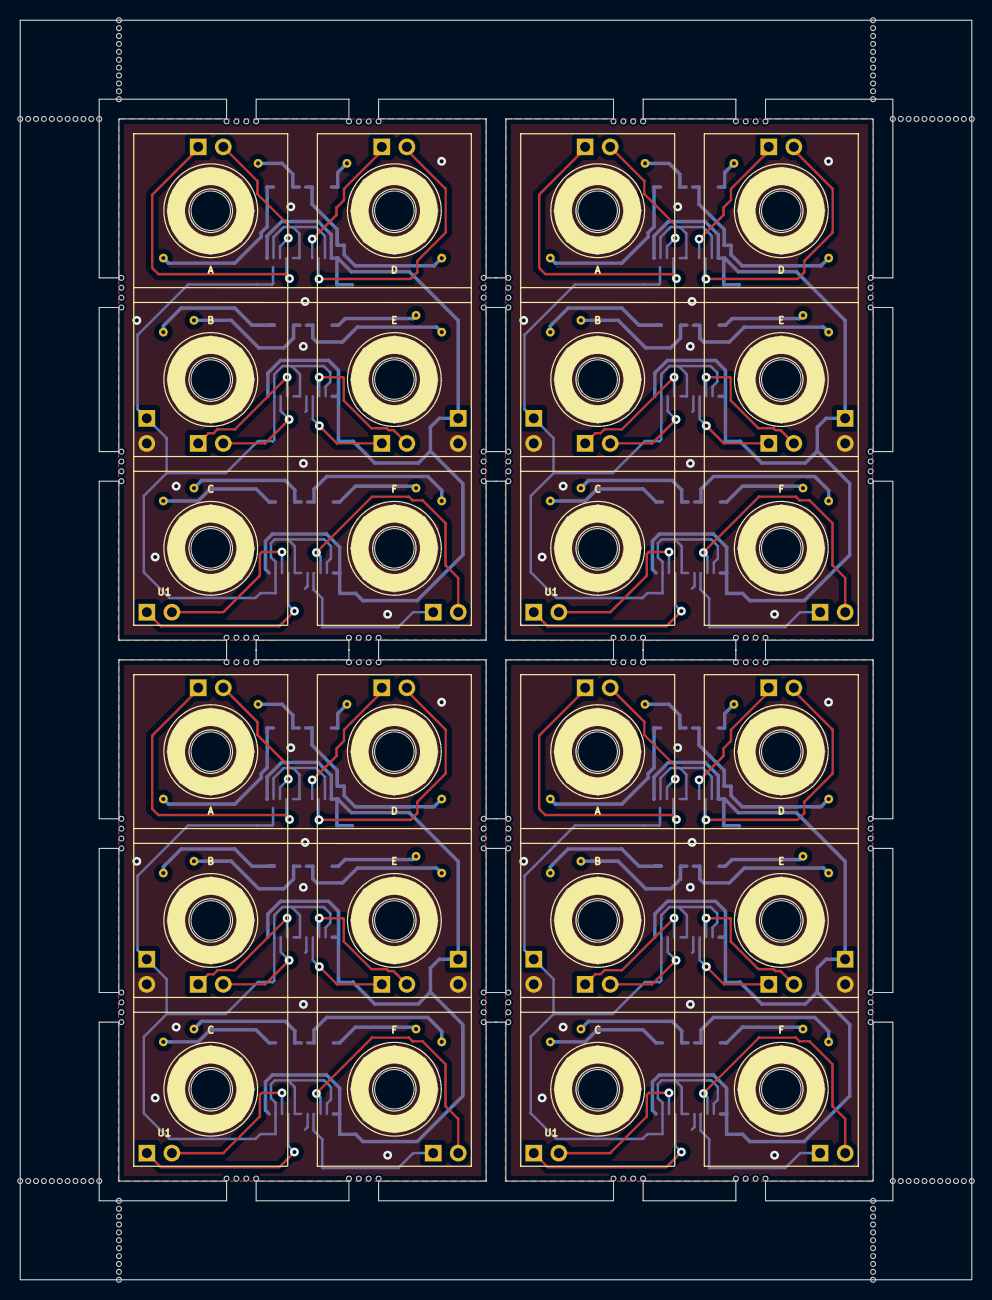
[picture p26: board Top_layer_Panel.kicad_pcb from above]

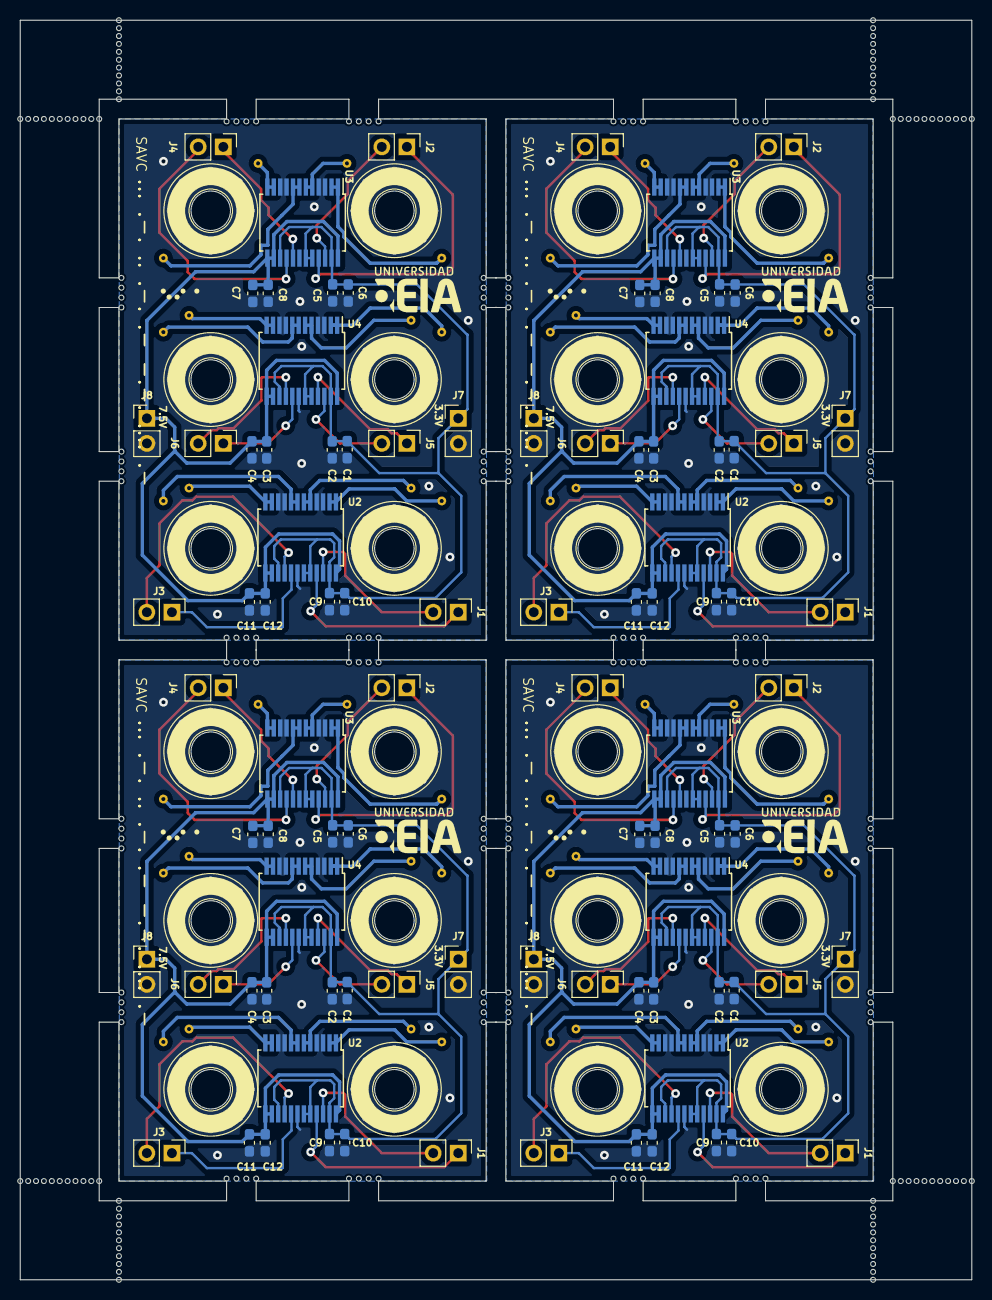
[picture p27: board Top_layer_Panel.kicad_pcb from below]

Board: 2 copper layers, 96.4 x 127.6 mm, 312 parts (92 on the bottom side), 108 nets.

Parts:
C1, C1#2, C1#3, C1#4, C4, C4#2, C4#3, C4#4, C5, C5#2, C5#3, C5#4, C8, C8#2, C8#3, C8#4, C9, C9#2, C9#3, C9#4, C12, C12#2, C12#3, C12#4: 10uF; C_0603_1608Metric_Pad1.08x0.95mm_HandSolder
C2, C2#2, C2#3, C2#4, C3, C3#2, C3#3, C3#4, C6, C6#2, C6#3, C6#4, C7, C7#2, C7#3, C7#4, C10, C10#2, C10#3, C10#4, C11, C11#2, C11#3, C11#4: 100nF; C_0603_1608Metric_Pad1.08x0.95mm_HandSolder
J1, J1#2, J1#3, J1#4, J2, J2#2, J2#3, J2#4, J3, J3#2, J3#3, J3#4, J4, J4#2, J4#3, J4#4, J5, J5#2, J5#3, J5#4, J6, J6#2, J6#3, J6#4, J7, J7#2, J7#3, J7#4, J8, J8#2, J8#3, J8#4: Conn_01x02_Male; PinHeader_1x02_P2.54mm_Vertical
KiKit_MB_1_1, KiKit_MB_1_2, KiKit_MB_1_3, KiKit_MB_1_4, KiKit_MB_2_1, KiKit_MB_2_2, KiKit_MB_2_3, KiKit_MB_2_4, KiKit_MB_3_1, KiKit_MB_3_2, KiKit_MB_3_3, KiKit_MB_3_4, KiKit_MB_4_1, KiKit_MB_4_2, KiKit_MB_4_3, KiKit_MB_4_4, KiKit_MB_5_1, KiKit_MB_5_2, KiKit_MB_5_3, KiKit_MB_5_4, KiKit_MB_6_1, KiKit_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
U1, U1#2, U1#3, U1#4: Electromagnets
U2, U2#2, U2#3, U2#4, U3, U3#2, U3#3, U3#4, U4, U4#2, U4#3, U4#4: TB6612FNG; SSOP-24_5.3x8.2mm_P0.65mm

Connections:
Board_0-+3.3V: C1#4.1, C2.1, C5.1, C6#3.1, C9#2.1, C10.1, J7#3.1, U2#3.15 (PWMB), U2#3.19 (STBY), U2#3.20 (VCC), U2#3.23 (PWMA), U3#3.15 (PWMB), U3#3.19 (STBY), U3#3.20 (VCC), U3#3.23 (PWMA), U4#2.15 (PWMB), U4#2.19 (STBY), U4#2.20 (VCC), U4#2.23 (PWMA)
Board_0-+7.5V: C3#2.1, C4#2.1, C7#2.1, C8#2.1, C11#2.1, C12#2.1, J8#4.1, U2#3.13 (VM2), U2#3.14 (VM3), U2#3.24 (VM1), U3#3.13 (VM2), U3#3.14 (VM3), U3#3.24 (VM1), U4#2.13 (VM2), U4#2.14 (VM3), U4#2.24 (VM1)
Board_0-A1: J2#4.1, U3#3.21 (AIN1)
Board_0-A2: J2#4.2, U3#3.22 (AIN2)
Board_0-B1: J5#3.1, U4#2.21 (AIN1)
Board_0-B2: J5#3.2, U4#2.22 (AIN2)
Board_0-C1: J1#4.1, U2#3.21 (AIN1)
Board_0-C2: J1#4.2, U2#3.22 (AIN2)
Board_0-D1: J4#4.1, U3#3.17 (BIN1)
Board_0-D2: J4#4.2, U3#3.16 (BIN2)
Board_0-E1: J6.1, U4#2.17 (BIN1)
Board_0-E2: J6.2, U4#2.16 (BIN2)
Board_0-F1: J3#4.1, U2#3.17 (BIN1)
Board_0-F2: J3#4.2, U2#3.16 (BIN2)
Board_0-GND: C1#4.2, C2.2, C3#2.2, C4#2.2, C5.2, C6#3.2, C7#2.2, C8#2.2, C9#2.2, C10.2, C11#2.2, C12#2.2, J7#3.2, J8#4.2, U2#3.3 (PGND1), U2#3.4 (PGND1), U2#3.9 (PGND2), U2#3.10 (PGND2), U2#3.18 (GND), U3#3.3 (PGND1), U3#3.4 (PGND1), U3#3.9 (PGND2), U3#3.10 (PGND2), U3#3.18 (GND), U4#2.3 (PGND1), U4#2.4 (PGND1), U4#2.9 (PGND2), U4#2.10 (PGND2), U4#2.18 (GND)
Board_0-Net-(U1A-A1): U1#3.1 (A1), U3#3.1 (AO1), U3#3.2 (AO1)
Board_0-Net-(U1A-A2): U1#3.2 (A2), U3#3.5 (AO2), U3#3.6 (AO2)
Board_0-Net-(U1B-B1): U1#3.3 (B1), U4#2.1 (AO1), U4#2.2 (AO1)
Board_0-Net-(U1B-B2): U1#3.4 (B2), U4#2.5 (AO2), U4#2.6 (AO2)
Board_0-Net-(U1C-C1): U1#3.5 (C1), U2#3.1 (AO1), U2#3.2 (AO1)
Board_0-Net-(U1C-C2): U1#3.6 (C2), U2#3.5 (AO2), U2#3.6 (AO2)
Board_0-Net-(U1D-D1): U1#3.7 (D1), U3#3.11 (BO1), U3#3.12 (BO1)
Board_0-Net-(U1D-D2): U1#3.8 (D2), U3#3.7 (BO2), U3#3.8 (BO2)
Board_0-Net-(U1E-E1): U1#3.9 (E1), U4#2.11 (BO1), U4#2.12 (BO1)
Board_0-Net-(U1E-E2): U1#3.10 (E2), U4#2.7 (BO2), U4#2.8 (BO2)
Board_0-Net-(U1F-F1): U1#3.11 (F1), U2#3.11 (BO1), U2#3.12 (BO1)
Board_0-Net-(U1F-F2): U1#3.12 (F2), U2#3.7 (BO2), U2#3.8 (BO2)
Board_1-+3.3V: C1#2.1, C2#4.1, C5#4.1, C6.1, C9#4.1, C10#3.1, J7.1, U2#4.15 (PWMB), U2#4.19 (STBY), U2#4.20 (VCC), U2#4.23 (PWMA), U3#4.15 (PWMB), U3#4.19 (STBY), U3#4.20 (VCC), U3#4.23 (PWMA), U4.15 (PWMB), U4.19 (STBY), U4.20 (VCC), U4.23 (PWMA)
Board_1-+7.5V: C3#4.1, C4#4.1, C7#3.1, C8.1, C11#4.1, C12#3.1, J8#2.1, U2#4.13 (VM2), U2#4.14 (VM3), U2#4.24 (VM1), U3#4.13 (VM2), U3#4.14 (VM3), U3#4.24 (VM1), U4.13 (VM2), U4.14 (VM3), U4.24 (VM1)
Board_1-A1: J2.1, U3#4.21 (AIN1)
Board_1-A2: J2.2, U3#4.22 (AIN2)
Board_1-B1: J5#4.1, U4.21 (AIN1)
Board_1-B2: J5#4.2, U4.22 (AIN2)
Board_1-C1: J1#3.1, U2#4.21 (AIN1)
Board_1-C2: J1#3.2, U2#4.22 (AIN2)
Board_1-D1: J4#2.1, U3#4.17 (BIN1)
Board_1-D2: J4#2.2, U3#4.16 (BIN2)
Board_1-E1: J6#2.1, U4.17 (BIN1)
Board_1-E2: J6#2.2, U4.16 (BIN2)
Board_1-F1: J3#3.1, U2#4.17 (BIN1)
Board_1-F2: J3#3.2, U2#4.16 (BIN2)
Board_1-GND: C1#2.2, C2#4.2, C3#4.2, C4#4.2, C5#4.2, C6.2, C7#3.2, C8.2, C9#4.2, C10#3.2, C11#4.2, C12#3.2, J7.2, J8#2.2, U2#4.3 (PGND1), U2#4.4 (PGND1), U2#4.9 (PGND2), U2#4.10 (PGND2), U2#4.18 (GND), U3#4.3 (PGND1), U3#4.4 (PGND1), U3#4.9 (PGND2), U3#4.10 (PGND2), U3#4.18 (GND), U4.3 (PGND1), U4.4 (PGND1), U4.9 (PGND2), U4.10 (PGND2), U4.18 (GND)
Board_1-Net-(U1A-A1): U1#4.1 (A1), U3#4.1 (AO1), U3#4.2 (AO1)
Board_1-Net-(U1A-A2): U1#4.2 (A2), U3#4.5 (AO2), U3#4.6 (AO2)
Board_1-Net-(U1B-B1): U1#4.3 (B1), U4.1 (AO1), U4.2 (AO1)
Board_1-Net-(U1B-B2): U1#4.4 (B2), U4.5 (AO2), U4.6 (AO2)
Board_1-Net-(U1C-C1): U1#4.5 (C1), U2#4.1 (AO1), U2#4.2 (AO1)
Board_1-Net-(U1C-C2): U1#4.6 (C2), U2#4.5 (AO2), U2#4.6 (AO2)
Board_1-Net-(U1D-D1): U1#4.7 (D1), U3#4.11 (BO1), U3#4.12 (BO1)
Board_1-Net-(U1D-D2): U1#4.8 (D2), U3#4.7 (BO2), U3#4.8 (BO2)
Board_1-Net-(U1E-E1): U1#4.9 (E1), U4.11 (BO1), U4.12 (BO1)
Board_1-Net-(U1E-E2): U1#4.10 (E2), U4.7 (BO2), U4.8 (BO2)
Board_1-Net-(U1F-F1): U1#4.11 (F1), U2#4.11 (BO1), U2#4.12 (BO1)
Board_1-Net-(U1F-F2): U1#4.12 (F2), U2#4.7 (BO2), U2#4.8 (BO2)
Board_2-+3.3V: C1.1, C2#3.1, C5#2.1, C6#4.1, C9#3.1, C10#4.1, J7#4.1, U2#2.15 (PWMB), U2#2.19 (STBY), U2#2.20 (VCC), U2#2.23 (PWMA), U3#2.15 (PWMB), U3#2.19 (STBY), U3#2.20 (VCC), U3#2.23 (PWMA), U4#4.15 (PWMB), U4#4.19 (STBY), U4#4.20 (VCC), U4#4.23 (PWMA)
Board_2-+7.5V: C3#3.1, C4.1, C7.1, C8#4.1, C11#3.1, C12.1, J8#3.1, U2#2.13 (VM2), U2#2.14 (VM3), U2#2.24 (VM1), U3#2.13 (VM2), U3#2.14 (VM3), U3#2.24 (VM1), U4#4.13 (VM2), U4#4.14 (VM3), U4#4.24 (VM1)
Board_2-A1: J2#2.1, U3#2.21 (AIN1)
Board_2-A2: J2#2.2, U3#2.22 (AIN2)
Board_2-B1: J5#2.1, U4#4.21 (AIN1)
Board_2-B2: J5#2.2, U4#4.22 (AIN2)
Board_2-C1: J1#2.1, U2#2.21 (AIN1)
Board_2-C2: J1#2.2, U2#2.22 (AIN2)
Board_2-D1: J4#3.1, U3#2.17 (BIN1)
Board_2-D2: J4#3.2, U3#2.16 (BIN2)
Board_2-E1: J6#3.1, U4#4.17 (BIN1)
Board_2-E2: J6#3.2, U4#4.16 (BIN2)
Board_2-F1: J3#2.1, U2#2.17 (BIN1)
Board_2-F2: J3#2.2, U2#2.16 (BIN2)
Board_2-GND: C1.2, C2#3.2, C3#3.2, C4.2, C5#2.2, C6#4.2, C7.2, C8#4.2, C9#3.2, C10#4.2, C11#3.2, C12.2, J7#4.2, J8#3.2, U2#2.3 (PGND1), U2#2.4 (PGND1), U2#2.9 (PGND2), U2#2.10 (PGND2), U2#2.18 (GND), U3#2.3 (PGND1), U3#2.4 (PGND1), U3#2.9 (PGND2), U3#2.10 (PGND2), U3#2.18 (GND), U4#4.3 (PGND1), U4#4.4 (PGND1), U4#4.9 (PGND2), U4#4.10 (PGND2), U4#4.18 (GND)
Board_2-Net-(U1A-A1): U1.1 (A1), U3#2.1 (AO1), U3#2.2 (AO1)
Board_2-Net-(U1A-A2): U1.2 (A2), U3#2.5 (AO2), U3#2.6 (AO2)
Board_2-Net-(U1B-B1): U1.3 (B1), U4#4.1 (AO1), U4#4.2 (AO1)
Board_2-Net-(U1B-B2): U1.4 (B2), U4#4.5 (AO2), U4#4.6 (AO2)
Board_2-Net-(U1C-C1): U1.5 (C1), U2#2.1 (AO1), U2#2.2 (AO1)
Board_2-Net-(U1C-C2): U1.6 (C2), U2#2.5 (AO2), U2#2.6 (AO2)
Board_2-Net-(U1D-D1): U1.7 (D1), U3#2.11 (BO1), U3#2.12 (BO1)
Board_2-Net-(U1D-D2): U1.8 (D2), U3#2.7 (BO2), U3#2.8 (BO2)
Board_2-Net-(U1E-E1): U1.9 (E1), U4#4.11 (BO1), U4#4.12 (BO1)
Board_2-Net-(U1E-E2): U1.10 (E2), U4#4.7 (BO2), U4#4.8 (BO2)
Board_2-Net-(U1F-F1): U1.11 (F1), U2#2.11 (BO1), U2#2.12 (BO1)
Board_2-Net-(U1F-F2): U1.12 (F2), U2#2.7 (BO2), U2#2.8 (BO2)
Board_3-+3.3V: C1#3.1, C2#2.1, C5#3.1, C6#2.1, C9.1, C10#2.1, J7#2.1, U2.15 (PWMB), U2.19 (STBY), U2.20 (VCC), U2.23 (PWMA), U3.15 (PWMB), U3.19 (STBY), U3.20 (VCC), U3.23 (PWMA), U4#3.15 (PWMB), U4#3.19 (STBY), U4#3.20 (VCC), U4#3.23 (PWMA)
Board_3-+7.5V: C3.1, C4#3.1, C7#4.1, C8#3.1, C11.1, C12#4.1, J8.1, U2.13 (VM2), U2.14 (VM3), U2.24 (VM1), U3.13 (VM2), U3.14 (VM3), U3.24 (VM1), U4#3.13 (VM2), U4#3.14 (VM3), U4#3.24 (VM1)
Board_3-A1: J2#3.1, U3.21 (AIN1)
Board_3-A2: J2#3.2, U3.22 (AIN2)
Board_3-B1: J5.1, U4#3.21 (AIN1)
Board_3-B2: J5.2, U4#3.22 (AIN2)
Board_3-C1: J1.1, U2.21 (AIN1)
Board_3-C2: J1.2, U2.22 (AIN2)
Board_3-D1: J4.1, U3.17 (BIN1)
Board_3-D2: J4.2, U3.16 (BIN2)
Board_3-E1: J6#4.1, U4#3.17 (BIN1)
Board_3-E2: J6#4.2, U4#3.16 (BIN2)
Board_3-F1: J3.1, U2.17 (BIN1)
Board_3-F2: J3.2, U2.16 (BIN2)
Board_3-GND: C1#3.2, C2#2.2, C3.2, C4#3.2, C5#3.2, C6#2.2, C7#4.2, C8#3.2, C9.2, C10#2.2, C11.2, C12#4.2, J7#2.2, J8.2, U2.3 (PGND1), U2.4 (PGND1), U2.9 (PGND2), U2.10 (PGND2), U2.18 (GND), U3.3 (PGND1), U3.4 (PGND1), U3.9 (PGND2), U3.10 (PGND2), U3.18 (GND), U4#3.3 (PGND1), U4#3.4 (PGND1), U4#3.9 (PGND2), U4#3.10 (PGND2), U4#3.18 (GND)
Board_3-Net-(U1A-A1): U1#2.1 (A1), U3.1 (AO1), U3.2 (AO1)
Board_3-Net-(U1A-A2): U1#2.2 (A2), U3.5 (AO2), U3.6 (AO2)
Board_3-Net-(U1B-B1): U1#2.3 (B1), U4#3.1 (AO1), U4#3.2 (AO1)
Board_3-Net-(U1B-B2): U1#2.4 (B2), U4#3.5 (AO2), U4#3.6 (AO2)
Board_3-Net-(U1C-C1): U1#2.5 (C1), U2.1 (AO1), U2.2 (AO1)
Board_3-Net-(U1C-C2): U1#2.6 (C2), U2.5 (AO2), U2.6 (AO2)
Board_3-Net-(U1D-D1): U1#2.7 (D1), U3.11 (BO1), U3.12 (BO1)
Board_3-Net-(U1D-D2): U1#2.8 (D2), U3.7 (BO2), U3.8 (BO2)
Board_3-Net-(U1E-E1): U1#2.9 (E1), U4#3.11 (BO1), U4#3.12 (BO1)
Board_3-Net-(U1E-E2): U1#2.10 (E2), U4#3.7 (BO2), U4#3.8 (BO2)
Board_3-Net-(U1F-F1): U1#2.11 (F1), U2.11 (BO1), U2.12 (BO1)
Board_3-Net-(U1F-F2): U1#2.12 (F2), U2.7 (BO2), U2.8 (BO2)
