vekkax/Braille_Display/Codes/Braille_firmware/Braille_firmware.ioc

Mcu.UserName=STM32C031G6Ux
PA1.Signal=USART1_RX
PA15.GPIO_Label=Buzzer
PA15.Signal=S_TIM1_CH1
PA2.Signal=USART2_TX
PA3.Signal=USART2_RX
PA4.GPIO_Label=F1
PA4.Signal=GPIO_Output
PA5.GPIO_Label=F2
PA5.Signal=GPIO_Output
PA8.GPIO_Label=C1
PA8.Signal=GPIO_Output
PB0.GPIO_Label=B2
PB0.Signal=GPIO_Output
PB1.GPIO_Label=B1
PB1.Signal=GPIO_Output
PB3.GPIO_Label=D2
PB3.Signal=GPIO_Output
PB4.GPIO_Label=D1
PB4.Signal=GPIO_Output
PB5.GPIO_Label=E1
PB5.Signal=GPIO_Output
PB6.GPIO_Label=E2
PB6.Signal=GPIO_Output
PB7.Signal=I2C1_SDA
PB8.Signal=I2C1_SCL
PC6.GPIO_Label=C2
PC6.Signal=GPIO_Output
