vekkax/Braille_Display/Codes/Test/UART_test/Core/Inc/main.h

#define F1_Pin GPIO_PIN_4
#define F1_GPIO_Port GPIOA
#define F2_Pin GPIO_PIN_5
#define F2_GPIO_Port GPIOA
#define B2_Pin GPIO_PIN_0
#define B2_GPIO_Port GPIOB
#define B1_Pin GPIO_PIN_1
#define B1_GPIO_Port GPIOB
#define C1_Pin GPIO_PIN_8
#define C1_GPIO_Port GPIOA
#define C2_Pin GPIO_PIN_6
#define C2_GPIO_Port GPIOC
#define A1_Pin GPIO_PIN_11
#define A1_GPIO_Port GPIOA
#define A2_Pin GPIO_PIN_12
#define A2_GPIO_Port GPIOA
#define Buzzer_Pin GPIO_PIN_15
#define Buzzer_GPIO_Port GPIOA
#define D2_Pin GPIO_PIN_3
#define D2_GPIO_Port GPIOB
#define D1_Pin GPIO_PIN_4
#define D1_GPIO_Port GPIOB
#define E1_Pin GPIO_PIN_5
#define E1_GPIO_Port GPIOB
#define E2_Pin GPIO_PIN_6
#define E2_GPIO_Port GPIOB
