vekkax/Braille_Display/(commit log)

2025-09-04 Remove tracked files except Print_files
    [2_pin_ear_female.0002.ipt, 2_pin_ear_female.ipt, 2_pin_no_ear_male.0001.ipt, 2_pin_no_ear_male.ipt, 3_pin_ear_female.0002.ipt, 3_pin_ear_female.ipt, 3_pin_no_ear_male.0001.ipt, 3_pin_no_ear_male.ipt]
2025-09-04 enclosure print files
    [[24 piezas] cam.stl, [24 piezas] dot.stl, [4 piezas] inner_bttm.stl, [4 piezas] inner_conn.stl, [4 piezas] inner_top.stl, [4 piezas] shell_bttm.stl, [4 piezas] shell_top.stl]
2025-10-06 uart frame parser and builder added
2025-10-21 logic.c overhauled, arduino middleware and minimal frontend added
2025-10-21 handle_reset expanded to restart frame parser and ARQ
2025-10-22 pump parser and inbox fixed, expanded reset and anchor role assignment
2025-10-22 individual uart contexts for ARQ added
2025-10-24 UART test programs and Documentation UMLs
