vekkax/Braille_Display/(notices)

Notices in the files:
Codes/Test/UART_test/Core/Inc/main.h:
Copyright (c) 2025 STMicroelectronics.
All rights reserved.
This software is licensed under terms that can be found in the LICENSE file
